Interbotix/ArbotixPro/README.md

# ArbotixPro
Eagle design files for Arbotix-Pro Robocontroller & source for CM730-compatible & ROS firmware versions.
