Interbotix/ArbotixPro/software/arbotixpro_cm730_firmware/README.md

# ArbotixPro-Firmware
Modified CM730 Firmware from ROBOTIS, compatible with HR-OS1/5 Framework

Compiled on Ubuntu 14.10, dependencies: https://launchpad.net/~terry.guo/+archive/ubuntu/gcc-arm-embedded
