Interbotix/ArbotixPro/hardware/CM730-ArbotixPro Pin Mappings.xlsx

STM32F10 Pin | Description | CM-730 | Arbotix-Pro | Notes | Legend
1 | Vbat | 3.3V | 3.3V |  | Pin Difference between CM-730 and Arbotix-Pro
2 | PC13-Tamper-RTC | LED_TX | LED_TX |  | CM-730 Pinout
3 | PC14 | LED_RX | LED_RX |  | Arbotix-Pro Pinout
4 | PC15 | LED2 | LED2
5 | OSC_IN | XTAL1 | XTAL1
6 | OSC_OUT | XTAL2 | XTAL2
7 | NRST | RESET | RESET
8 | PC0-ADC0 | SIG_ADC0 | SIG_ADC0
9 | PC1-ADC1 | SIG_ADC1 | SIG_ADC1
10 | PC2-ADC2 | SIG_ADC2 | SIG_ADC2
11 | PC3-ADC3 | SIG_ADC3 | SIG_ADC3
12 | VSSA | GND | GND
13 | VDDA | 3.3V | 3.3V
14 | PA0-ADC4 | SIG_ADC4 | SIG_ADC4
15 | PA1-ADC5 | SIG_ADC5 | SIG_ADC5
16 | PA2-ADC6 | SIG_ADC6 | SIG_ADC6
17 | PA3-ADC7 | SIG_ADC7 | SIG_ADC7
18 | VSS4 | GND | GND
19 | VDD4 | 3.3V | 3.3V
20 | PA4-ADC8 | SIG_ADC8 | SIG_ADC8
21 | PA5-ADC9 | SIG_ADC9 | SIG_ADC9
22 | PA6-ADC10 | SIG_ADC10 | SIG_ADC10
23 | PA7-ADC11 | SIG_ADC11 | SIG_ADC11
24 | PC4-ADC12 | SIG_ADC12 | SIG_ADC12
25 | PC5-ADC13 | SIG_ADC13 | SIG_ADC13
26 | PB0-ADC14 | SIG_ADC14 | SIG_ADC14
27 | PB1-ADC15 | SIG_ADC15 | SIG_ADC15
28 | PB2-BOOT1 | BOOT1/GND | BOOT1/GND
29 | PB10-TX3 | PC_TXD | PC_TXD
30 | PB11-RX3 | PC_RXD | PC_RXD
31 | VSS1 | GND | GND
32 | VDD1 | 3.3V | 3.3V
33 | PB12 | LED3 | LED3
34 | PB13-SCK2 | SIG_SCK | SIG_SCK
35 | PB14-MISO2 | SIG_MISO | SIG_MISO
36 | PB15-MOSI2 | SIG_MOSI | SIG_MOSI
37 | PC6-SDIO-D6 | LED4 | LED4
38 | PC7-SDIO-D7 | LED5_R | PIN_PC7
39 | PC8-SDIO-D0 | LED5_G | ENABLE_ZIGBEE
40 | PC9-SDIO-D1 | LED5_B | ENABLE_TX
41 | PA8 | LED6_R | PIN_PA8
42 | PA9-TX1 | CPU_TXD | CPU_TXD
43 | PA10-RX1 | CPU_RXD | CPU_RXD
44 | PA11-USBDM | LED6_G | SW_MODE
45 | PA12-USBDP | LED6_B | SW_START
46 | PA13-JTMS-SWDIO | USB_SLEEP | PIN_PA13 | JTMS
47 | VSS2 | GND | GND
48 | VDD2 | 3.3V | 3.3V
49 | PA14-JTCK-SWCLK | SW_MODE | PIN_PA14 | JTCK
50 | PA15-JTDI | SW_START | PIN_PA15 | JTDI
51 | PC10-TX4 | SIG_ACC_CS | SIG_ACC_CS
52 | PC11-RX4 | SIG_GYRO_CS | SIG_GYRO_CS
53 | PC12-TX5 | ZIGBEE_TXD | ZIGBEE_TXD
54 | PD2-RX5 | ZIGBEE_RXD | ZIGBEE_RXD
55 | PB3-JTDO | ENABLE_ZIGBEE | PIN_PB3 | JTDO
56 | PB4-MISO3 | ENABLE_TX | PIN_PB4 | NJRST
57 | PB5-MOSI3 | ENABLE_RX | ENABLE_RX
58 | PB6-TX1 | DXLTXD | DXLTXD
59 | PB7-RX1 | DXLRXD | DXLRXD
60 | BOOT0 | BOOT0/GND | BOOT0/GND
61 | PB8-D4 | ENABLE_DXLPWR | ENABLE_DXLPWR
62 | PB9-D5 | SIG_BUZZER | SIG_BUZZER
63 | VSS3 | GND | GND
64 | VDD3 | 3.3V | 3.3V
