Interbotix/ArbotixPro/hardware/arbotixpro.png

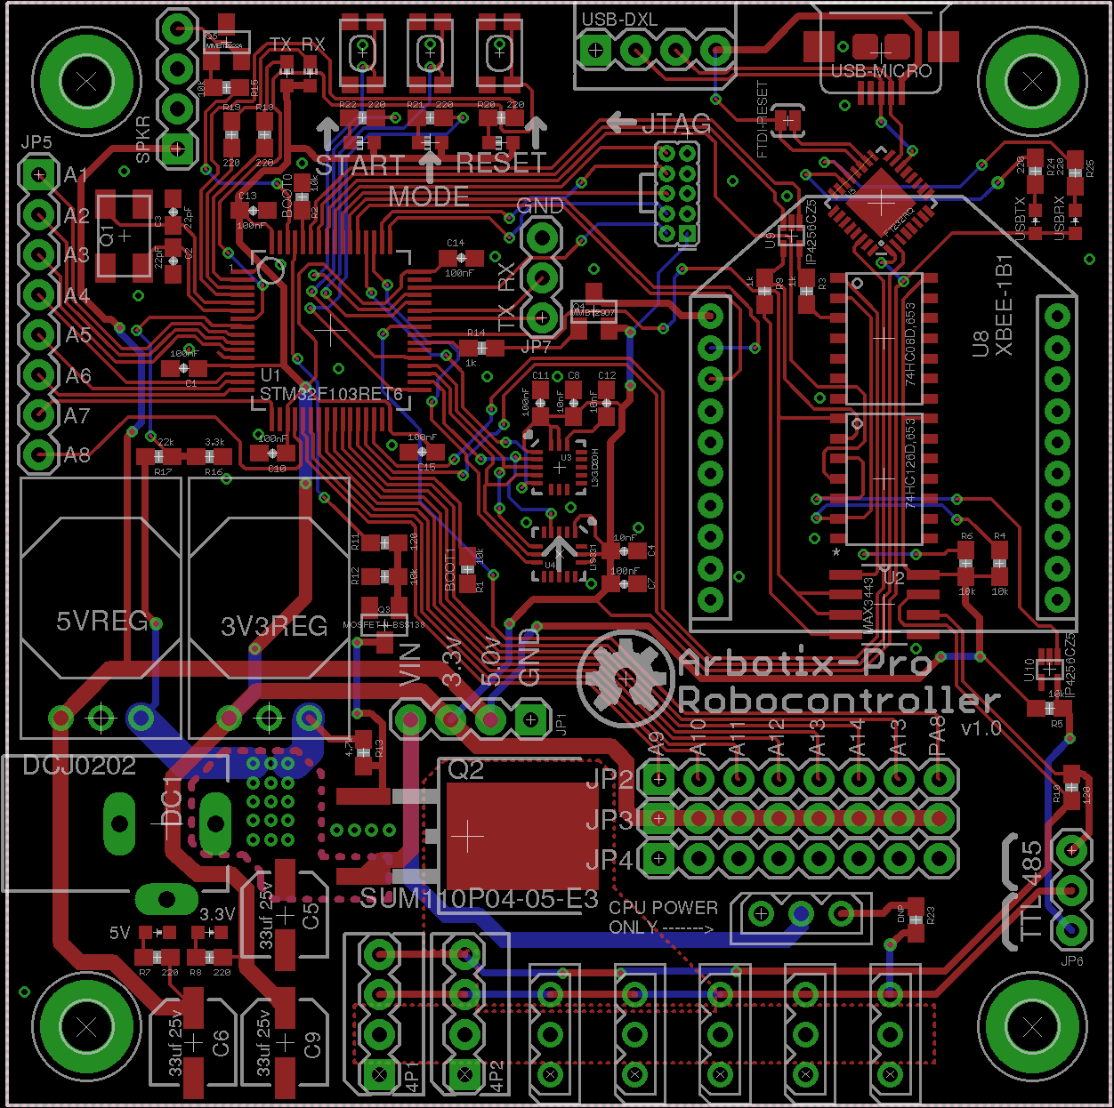
hardware/arbotixpro.png
