Interbotix/ArbotixPro/hardware/jtag.png

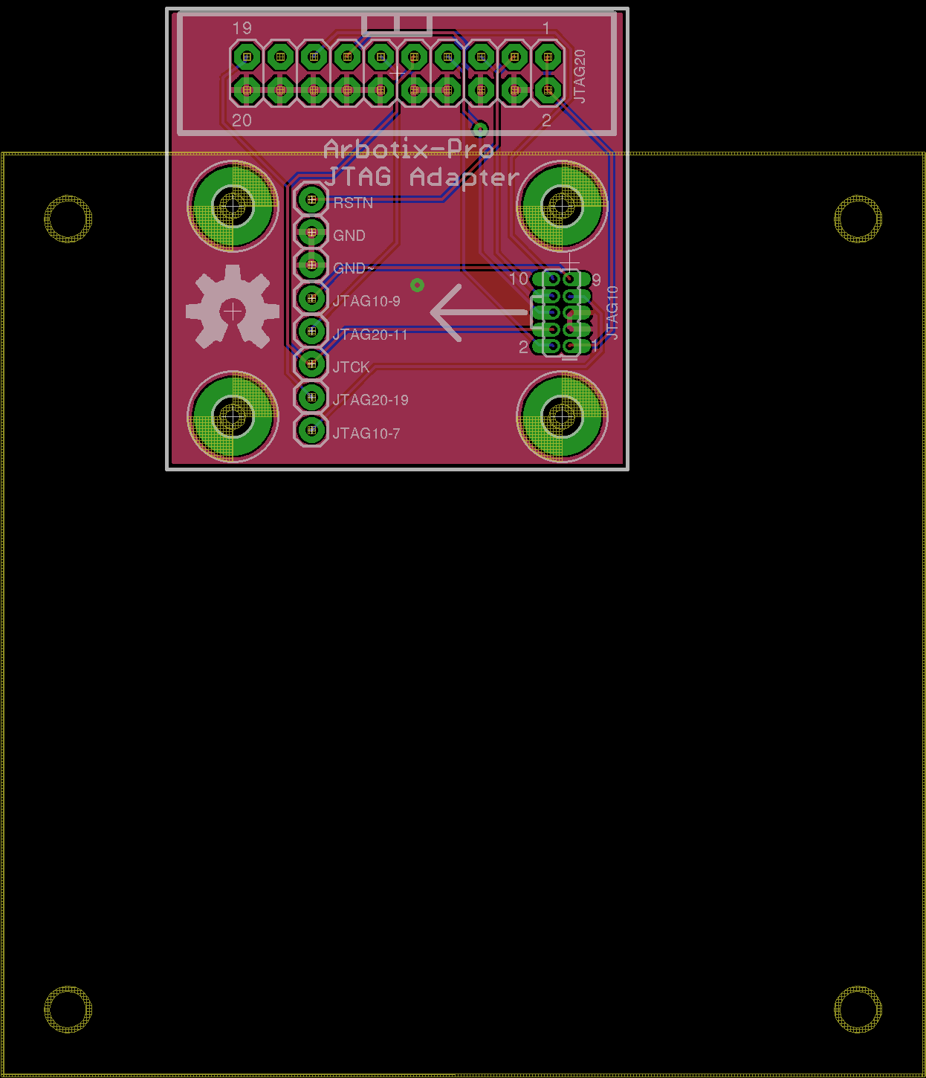
hardware/jtag.png
