Interbotix/ArbotixPro/hardware/Arbotix-Pro Digikey BOM v11.xlsx

Sheet: Part List Report
#ITEM | Description | Designator | Manufacturer | Manufacturer Part Number# | Supplier | EagleCAD Device | Supplier Part # | QTY/BOARD
1 | LED 1.6X0.8MM 568NM GRN CLR SMD | 3.3V, 5V, MODE, RESET, START, TX, RX, USBTX, USBRX | KINGBRIGHT COMPANY LLC (VA) | APT1608SGC | Digi-Key | LEDCHIPLED_0603 | 754-1121-6-ND | 9
2 | CONN HEADER 3POS 2.5MM VERT TIN | 3P1, 3P2, 3P3, 3P4, 3P5, CPU-POWER | MOLEX INC | 22035035 | Digi-Key | WM18887-ND | WM18887-ND | 6
3 | CONV DC/DC 1.5A 24VIN 3.3VOUT | 3V3REG | MURATA POWER SOLUTIONS INC | OKI-78SR-3.3/1.5-W36H-C | Digi-Key | DCDC_OKI-78SR | 811-3014-ND | 1
4 | CONN HEADER 4POS 2.5MM VERT TIN | 4P1, 4P2, USB-DXL | MOLEX INC | 22035045 | Digi-Key | M04PTH | WM18888-ND | 3
5 | DC/DC CONVERTER 5V 8W | 5VREG | MURATA POWER SOLUTIONS INC | OKI-78SR-5/1.5-W36H-C | Digi-Key | DCDC_OKI-78SR | 811-2692-ND | 1
6 | CAP CER 0.1UF 50V 10% X7R 0603 | C1, C7, C10, C11, C13, C14, C15 | TDK CORPORATION (VA) | C1608X7R1H104K080AA | Digi-Key | CAP0603-CAP | 445-1314-6-ND | 7
7 | CAP CER 22PF 50V 5% NP0 0603 | C2, C3 | MURATA ELECTRONICS (VA) | GRM1885C1H220JA01D | Digi-Key | 22PF-50V-5%(0603) | 490-1411-6-ND | 2
8 | CAP CER 10000PF 25V 5% C0G 0603 | C4, C8, C12 | TDK CORPORATION (VA) | C1608C0G1E103J080AA | Digi-Key | CAP0603-CAP | 445-2664-6-ND | 3
9 | CAP ALUM 33UF 25V 20% SMD | C5, C6, C9 | PANASONIC ELECTRONIC COMPONENTS (VA) | EEE-1EA330WR | Digi-Key | CBP-SV-C | PCE3904DKR-ND | 3
10 | CONN JACK POWER 2.1MM PCB | DC1 | CUI INC | PJ-102A | Digi-Key | DCJ0202 | CP-102A-ND | 1
11 | DNP | FTDI-RESET | DNP | DNP | Digi-Key | SOLDERJUMPERNO | DNP | 0
12 | CONN HEADER .100" SNGL STR 4POS | JP1, SPKR | SULLINS CONNECTOR SOLUTIONS (VA) | PRPC004SAAN-RC | Digi-Key | M04PTH | S1011EC-04-ND | 2
13 | CONN HEADER .100" SNGL STR 8POS | JP2, JP3, JP4, JP5 | SULLINS CONNECTOR SOLUTIONS (VA) | PRPC008SAAN-RC | Digi-Key | M081X08 | S1011EC-08-ND | 4
14 | CONN HEADER .100" SNGL STR 3POS | JP6, JP7 | SULLINS CONNECTOR SOLUTIONS (VA) | PRPC003SAAN-RC | Digi-Key | M03PTH | S1011EC-03-ND | 2
15 | CONN HEADER .050" 10PS DL PCB AU | JTAG | SULLINS CONNECTOR SOLUTIONS | GRPB052VWVN-RC | Digi-Key | GRPB052VWVN-RC | S9015E-05-ND | 1
16 | CRYSTAL 8MHZ 18PF SMD | Q1 | ABRACON CORPORATION (VA) | ABM3B-8.000MHZ-B2-T | Digi-Key | AMB3B-25.000MHZ-B2-T8MHZ8MHZ | 535-9720-6-ND | 1
17 | MOSFET P-CH 40V 110A D2PAK | Q2 | VISHAY SILICONIX (VA) | SUM110P04-05-E3 | Digi-Key | SPB80P06P | SUM110P04-05-E3DKR-ND | 1
18 | MOSFET N-CH 50V 220MA SOT-23 | Q3 | FAIRCHILD SEMICONDUCTOR (VA) | BSS138 | Digi-Key | MOSFET-NCHANNELBSS138 | BSS138CT-ND | 1
19 | TRANS PNP 60V 0.8A SOT-23 | Q4 | FAIRCHILD SEMICONDUCTOR (VA) | MMBT2907A | Digi-Key | TRANSISTOR_PNPMMBT4403 | MMBT2907AFSDKR-ND | 1
20 | TRANS NPN 40V 1A SOT-23 | Q5 | FAIRCHILD SEMICONDUCTOR (VA) | MMBT2222A | Digi-Key | TRANSISTOR_PNPMMBT4403 | MMBT2222AFSDKR-ND | 1
21 | RES SMD 10K OHM 1% 1/10W 0603 | R1, R2, R4, R5, R6, R12, R15 | PANASONIC ELECTRONIC COMPONENTS (VA) | ERJ-3EKF1002V | Digi-Key | RESISTOR0603-RES | P10.0KHDKR-ND | 7
22 | RES SMD 1K OHM 1% 1/10W 0603 | R3, R9, R14 | PANASONIC ELECTRONIC COMPONENTS (VA) | ERJ-3EKF1001V | Digi-Key | RESISTOR0603-RES | P1.00KHDKR-ND | 3
23 | RES SMD 220 OHM 1% 1/10W 0603 | R7, R8, R18, R19, R20, R21, R22, R24, R25 | PANASONIC ELECTRONIC COMPONENTS (VA) | ERJ-3EKF2200V | Digi-Key | RESISTOR0603 | P220HDKR-ND | 9
24 | RES SMD 120 OHM 1% 1/10W 0603 | R10, R11 | PANASONIC ELECTRONIC COMPONENTS (VA) | ERJ-3EKF1200V | Digi-Key | RESISTOR0603-RES | P120HDKR-ND | 2
25 | RES SMD 4.7K OHM 1% 1/10W 0603 | R13 | PANASONIC ELECTRONIC COMPONENTS (VA) | ERJ-3EKF4701V | Digi-Key | RESISTOR0603-RES | P4.70KHDKR-ND | 1
26 | RES SMD 3.3K OHM 1% 1/10W 0603 | R16 | PANASONIC ELECTRONIC COMPONENTS (VA) | ERJ-3EKF3301V | Digi-Key | RESISTOR0603-RES | P3.30KHDKR-ND | 1
27 | RES SMD 22K OHM 1% 1/10W 0603 | R17 | PANASONIC ELECTRONIC COMPONENTS (VA) | ERJ-3EKF2202V | Digi-Key | RESISTOR0603-RES | P22.0KHDKR-ND | 1
28 | DNP | R23 | DNP | DNP | Digi-Key | RESISTOR0603 | DNP | 0
29 | SWITCH TACTILE SPST-NO 0.05A 32V | SW1, SW2, SW3 | C&K COMPONENTS (VA) | KMR221NG LFS | Digi-Key | SPST_TACT-KMR2 | CKN10244DKR-ND | 3
30 | MCU ARM 512KB FLASH MEM 64-LQFP | U1 | STMICROELECTRONICS | STM32F103RET6 | Digi-Key | STM32F103RET6 | 497-6444-ND | 1
31 | IC TXRX RS-485 8-SOIC | U2 | MAXIM INTEGRATED | MAX3443EASA+ | Digi-Key | MAX3443EESA+ | MAX3443EASA+-ND | 1
32 | IC MEMS MOTION SENSOR 16LLGA | U3 | STMICROELECTRONICS (VA) | L3GD20HTR | Digi-Key | L3GD20H | 497-13931-6-ND | 1
33 | ACCELEROMETER MEMS 3AXIS 16-LGA | U4 | STMICROELECTRONICS (VA) | LIS331DLHTR | Digi-Key | LIS331 | 497-10397-6-ND | 1
34 | IC USB FS SERIAL UART 32-QFN | U5 | FTDI (VA) | FT232RQ-REEL | Digi-Key | FT232RQ | 768-1008-6-ND | 1
35 | IC GATE AND 4CH 2-INP 14-SO | U6 | NXP SEMICONDUCTORS (VA) | 74HC08D,653 | Digi-Key | 74HCT08D,653 | 568-1386-6-ND | 1
36 | IC BUFFER DVR TRI-ST QD 14SOIC | U7 | NXP SEMICONDUCTORS (VA) | 74HC126D,653 | Digi-Key | 74HC126D,653 | 568-8130-6-ND | 1
37 | CONN RECEPT 2MM VERT AU 10POS | U8 | HARWIN INC | M22-7131042 | Digi-Key | XBEE-1B1 | 952-1354-5-ND | 2
38 | IC EMI FILTER ESD 2CH SOT665 | U9, U10 | NXP SEMICONDUCTORS (VA) | IP4256CZ5-W,115 | Digi-Key | IP4256CZ5-W,115 | 568-5871-6-ND | 2
39 | CONN RCPT MICRO USB B SMD R/A | USB-MICRO | HIROSE ELECTRIC CO LTD (VA) | ZX62-B-5PA(11) | Digi-Key | MICRO-USB-5P-340015001 | H11634DKR-ND | 1

Sheet: Project Information
Project Full Path
Project Filename
Variant Name
Data-Source Filename
Data-Source Full Path
Title
Total Quantity
Report Time
Report Date
Report Date & Tine
Output Name
Output Type
Output Generator Name
Output Generator Description

Sheet: EagleImport
User | QTY | Part | Value | Device | Package | Description | MF | MPN | OC_FARNELL | OC_NEWARK | PACKAGE | PROD_ID | SUPPLIER | VALUE
1 | 7 | 3.3V, 5V, MODE, RESET, START, TX, RX |  | LEDCHIPLED_0603 | CHIPLED_0603 | LED
2 | 6 | 3P1, 3P2, 3P3, 3P4, 3P5, CPU-POWER | WM18887-ND | WM18887-ND | BIOLOID | Bioloid Bus Header
3 | 1 | 3V3REG | DCDC_OKI-78SR-3.3 | DCDC_OKI-78SR | OKI-78SRH | 4.95W DC/DC Converter
4 | 3 | 4P1, 4P2, USB-DXL |  | M04PTH | 1X04 | Header 4
5 | 1 | 5VREG | DCDC_OKI-78SR-5 | DCDC_OKI-78SR | OKI-78SRH | 4.95W DC/DC Converter
6 | 7 | C1, C7, C10, C11, C13, C14, C15 | 100nF | CAP0603-CAP | 0603-CAP | Capacitor
7 | 2 | C2, C2 | 22pF | 22PF-50V-5%(0603) | 0603-CAP | CAP-07876 |  |  |  |  |  | CAP-07876 |  | 22pF
8 | 3 | C4, C8, C12 | 10nF | CAP0603-CAP | 0603-CAP | Capacitor
9 | 3 | C5, C6, C9 | 33uf 25v | CBP-SV-C | SV-C | BIPOLAR CAP
10 | 1 | DC1 | DCJ0202 | DCJ0202 | DCJ0202 | DC POWER JACK |  |  | unknown | unknown
11 | 0 | FTDI-RESET | DNP | SOLDERJUMPERNO | SJ_2S-NO | Solder Jumper
12 | 2 | JP1, SPKR |  | M04PTH | 1X04 | Header 4
13 | 4 | JP2, JP3, JP4, JP5 |  | M081X08 | 1X08 | Header 8
14 | 2 | JP6, JP7 |  | M03PTH | 1X03 | Header 3
15 | 1 | JTAG | GRPB052VWQS-RC | GRPB052VWQS-RC | DEBUG | CONN HEADER 0.050 10PS DL SMD AU"
16 | 1 | Q1 | 8MHZ | AMB3B-25.000MHZ-B2-T8MHZ8MHZ | 4LCC | CRYSTAL, 8.000MHZ 18PF SMD
17 | 1 | Q2 | SUM110P04-05-E3 | SPB80P06P | TO263 | SIPMOS (R) Power-Transistor P-Channel, Enhancement mode
18 | 1 | Q3 | MOSFET-N-BSS138 | MOSFET-NCHANNELBSS138 | SOT23 | Common NMOSFET Parts |  |  |  |  |  | TRANS-00830
19 | 1 | Q4 | MMBT2907 | TRANSISTOR_PNPMMBT4403 | SOT23 | Generic PNP BJT |  |  |  |  |  | TRANS-09245 |  | MMBT4403
20 | 1 | Q5 | MMBT2222A | TRANSISTOR_PNPMMBT4403 | SOT23 | Generic PNP BJT |  |  |  |  |  | TRANS-09245 |  | MMBT4403
21 | 7 | R1, R2, R4, R5, R6, R12, R15 | 10k | RESISTOR0603-RES | 0603-RES | Resistor
22 | 3 | R3, R9, R14 | 1k | RESISTOR0603-RES | 0603-RES | Resistor
23 | 7 | R7, R8, R18, R19, R20, R21, R22 | 220 | RESISTOR0603 | 0603-RES | Resistor
24 | 2 | R10, R11 | 120 | RESISTOR0603-RES | 0603-RES | Resistor
25 | 1 | R13 | 4.7k | RESISTOR0603-RES | 0603-RES | Resistor
26 | 1 | R16 | 3.3k | RESISTOR0603-RES | 0603-RES | Resistor
27 | 1 | R17 | 22k | RESISTOR0603-RES | 0603-RES | Resistor
28 | 0 | R23 | DNP | RESISTOR0603 | 0603-RES | Resistor
29 | 3 | SW1, SW2, SW3 | SPST_TACT-KMR2 | SPST_TACT-KMR2 | KMR2 | SMT 6mm switch, EVQQ2 series
30 | 1 | U1 | STM32F103RET6 | STM32F103RET6 | QFP50P1200X1200X160-64N | ARM-based 32-bit MCU |  | STM32F103RET6 | 1624138 | 01P4101 | QFP-64 |  | STMICROELECTRONICS
31 | 1 | U2 | MAX3443 | MAX3443EESA+ | SOIC127P600X175-8N | Transceivers |  | MAX3443EESA+ | 1593360 | 59J3022 | SOIC-8 |  | Maxim
32 | 1 | U3 | L3GD20H | L3GD20H | LGA16-3MM
33 | 1 | U4 | LIS331 | LIS331 | LGA16-3MM | 3-axis 6/12/24g SPI/I2C accelerometer
34 | 1 | U5 | FT232RQ | FT232RQ | QFN-32 | USB to USART. Non-stock item, unproven FP for this part.
35 | 1 | U6 | 74HC08D,653 | 74HCT08D,653 | 14-SOIC
36 | 1 | U7 | 74HC126D,653 | 74HC126D,653 | 14-SOIC
37 | 1 | U8 | XBEE-1B3 | XBEE-1B3 | XBEE-SMD | Xbee module footprints |  |  |  |  |  | CONN-09042
38 | 2 | U9, U10 | IP4256CZ5-W,115 | IP4256CZ5-W,115 | SOT665
39 | 1 | USB-MICRO | MICRO-USB-5P-340015001 | MICRO-USB-5P-340015001 | B-SMD-5P | ST-USB-001Eï¼šMICRO USB B SMD R/A

Sheet: digimport
Digi-Key Part Number | Manufacturer | Manufacturer Part Number | Description | Customer Reference | Quantity 1 | Price | Quantity 2 | Price | Quantity 3 | Price | Stock Status | Mfg Std Lead Time | Comments | RoHS Status | Lead Free Status | REACH Status
754-1121-6-ND | KINGBRIGHT COMPANY LLC (VA) | APT1608SGC | LED 1.6X0.8MM 568NM GRN CLR SMD | 1 | 9 | 0.93778 | 504 | 0.08409 | 1008 | 0.07714 | IN STOCK | 6-8 Weeks | Non-Cancelable/Non-Returnable | RoHS Compliant | Lead free | Unaffected Jun-2014
WM18887-ND | MOLEX INC | 22035035 | CONN HEADER 3POS 2.5MM VERT TIN | 2 | 6 | 0.53 | 336 | 0.34796 | 672 | 0.3314 | IN STOCK | 8 Weeks |  | RoHS Compliant | Lead free | Unaffected Dec-2009
811-3014-ND | MURATA POWER SOLUTIONS INC | OKI-78SR-3.3/1.5-W36H-C | CONV DC/DC 1.5A 24VIN 3.3VOUT | 3 | 1 | 4.74 | 56 | 4.336 | 112 | 4.2005 | IN STOCK | 10 Weeks |  | RoHS Compliant | Lead free | Not Available
WM18888-ND | MOLEX INC | 22035045 | CONN HEADER 4POS 2.5MM VERT TIN | 4 | 3 | 0.62 | 168 | 0.4487 | 336 | 0.40972 | IN STOCK | 8 Weeks |  | RoHS Compliant | Lead free | Unaffected Dec-2009
811-2692-ND | MURATA POWER SOLUTIONS INC | OKI-78SR-5/1.5-W36H-C | DC/DC CONVERTER 5V 8W | 5 | 1 | 4.3 | 56 | 4.04 | 112 | 3.78 | IN STOCK | 10 Weeks |  | RoHS Compliant | Lead free | Not Available
445-1314-6-ND | TDK CORPORATION (VA) | C1608X7R1H104K080AA | CAP CER 0.1UF 50V 10% X7R 0603 | 6 | 7 | 1.1 | 392 | 0.03587 | 784 | 0.02432 | IN STOCK | 10 Weeks | Non-Cancelable/Non-Returnable | RoHS Compliant | Lead free | Unaffected Apr-2011
490-1411-6-ND | MURATA ELECTRONICS (VA) | GRM1885C1H220JA01D | CAP CER 22PF 50V 5% NP0 0603 | 7 | 2 | 3.6 | 112 | 0.08134 | 224 | 0.05004 | IN STOCK | 18 Weeks | Non-Cancelable/Non-Returnable | RoHS Compliant | Lead free | Unaffected Jul-2011
445-2664-6-ND | TDK CORPORATION (VA) | C1608C0G1E103J080AA | CAP CER 10000PF 25V 5% C0G 0603 | 8 | 3 | 2.67333 | 168 | 0.18167 | 336 | 0.12583 | IN STOCK | 12 Weeks | Non-Cancelable/Non-Returnable | RoHS Compliant | Lead free | Unaffected Apr-2011
PCE3904DKR-ND | PANASONIC ELECTRONIC COMPONENTS (VA) | EEE-1EA330WR | CAP ALUM 33UF 25V 20% SMD | 9 | 3 | 2.77333 | 168 | 0.24929 | 336 | 0.17652 | IN STOCK | 21 Weeks | Non-Cancelable/Non-Returnable | RoHS Compliant | Lead free | Not Available
CP-102A-ND | CUI INC | PJ-102A | CONN JACK POWER 2.1MM PCB | 10 | 1 | 1 | 56 | 0.7 | 112 | 0.47 | IN STOCK | 11 Weeks |  | RoHS Compliant | Lead free | Unaffected Oct-2010
 |  |  |  | 11
S1011EC-04-ND | SULLINS CONNECTOR SOLUTIONS (VA) | PRPC004SAAN-RC | CONN HEADER .100" SNGL STR 4POS | 12 | 2 | 0.2 | 112 | 0.1443 | 224 | 0.1443 |  |  | No delivery date available | RoHS Compliant | Lead free | Unaffected Dec-2013
S1011EC-08-ND | SULLINS CONNECTOR SOLUTIONS (VA) | PRPC008SAAN-RC | CONN HEADER .100" SNGL STR 8POS | 13 | 4 | 0.26 | 224 | 0.1935 | 448 | 0.1935 |  |  | No delivery date available | RoHS Compliant | Lead free | Unaffected Dec-2013
S1011EC-03-ND | SULLINS CONNECTOR SOLUTIONS (VA) | PRPC003SAAN-RC | CONN HEADER .100" SNGL STR 3POS | 14 | 2 | 0.18 | 112 | 0.132 | 224 | 0.132 |  |  | No delivery date available | RoHS Compliant | Lead free | Unaffected Dec-2013
S9015E-05-ND | SULLINS CONNECTOR SOLUTIONS | GRPB052VWVN-RC | CONN HEADER .050" 10PS DL PCB AU | 15 | 1 | 0.9 | 56 | 0.6232 | 112 | 0.554 | IN STOCK | 2-4 Weeks |  | RoHS Compliant | Lead free | Unaffected Dec-2013
535-9720-6-ND | ABRACON CORPORATION (VA) | ABM3B-8.000MHZ-B2-T | CRYSTAL 8MHZ 18PF SMD | 16 | 1 | 8.04 | 56 | 0.98375 | 112 | 0.8225 | IN STOCK | 10 Weeks | Non-Cancelable/Non-Returnable | RoHS Compliant | Lead free | Unaffected Jun-2014
SUM110P04-05-E3DKR-ND | VISHAY SILICONIX (VA) | SUM110P04-05-E3 | MOSFET P-CH 40V 110A D2PAK | 17 | 1 | 11.92 | 56 | 4.09214 | 112 | 3.67063 | IN STOCK | 16 Weeks | Non-Cancelable/Non-Returnable | RoHS Compliant | Lead free | Unaffected Dec-2011
BSS138CT-ND | FAIRCHILD SEMICONDUCTOR (VA) | BSS138 | MOSFET N-CH 50V 220MA SOT-23 | 18 | 1 | 0.22 | 56 | 0.1408 | 112 | 0.1096 | IN STOCK | 6 Weeks | Alternate Packaging Exists | RoHS Compliant | Lead free | Unaffected Dec-2013
MMBT2907AFSDKR-ND | FAIRCHILD SEMICONDUCTOR (VA) | MMBT2907A | TRANS PNP 60V 0.8A SOT-23 | 19 | 1 | 7.2 | 56 | 0.295 | 112 | 0.18491 | IN STOCK | 6 Weeks | Non-Cancelable/Non-Returnable | RoHS Compliant | Lead free | Unaffected Dec-2013
MMBT2222AFSDKR-ND | FAIRCHILD SEMICONDUCTOR (VA) | MMBT2222A | TRANS NPN 40V 1A SOT-23 | 20 | 1 | 7.18 | 56 | 0.27821 | 112 | 0.17277 | IN STOCK | 6 Weeks | Non-Cancelable/Non-Returnable | RoHS Compliant | Lead free | Unaffected Dec-2013
P10.0KHDKR-ND | PANASONIC ELECTRONIC COMPONENTS (VA) | ERJ-3EKF1002V | RES SMD 10K OHM 1% 1/10W 0603 | 21 | 7 | 1.1 | 392 | 0.0263 | 784 | 0.01517 | IN STOCK | 7 Weeks | Non-Cancelable/Non-Returnable | RoHS Compliant | Lead free | Not Available
P1.00KHDKR-ND | PANASONIC ELECTRONIC COMPONENTS (VA) | ERJ-3EKF1001V | RES SMD 1K OHM 1% 1/10W 0603 | 22 | 3 | 2.43333 | 168 | 0.0531 | 336 | 0.02929 | IN STOCK | 7 Weeks | Non-Cancelable/Non-Returnable | RoHS Compliant | Lead free | Not Available
P220HDKR-ND | PANASONIC ELECTRONIC COMPONENTS (VA) | ERJ-3EKF2200V | RES SMD 220 OHM 1% 1/10W 0603 | 23 | 9 | 0.87778 | 504 | 0.02012 | 1008 | 0.0111 | IN STOCK | 7 Weeks | Non-Cancelable/Non-Returnable | RoHS Compliant | Lead free | Not Available
P120HDKR-ND | PANASONIC ELECTRONIC COMPONENTS (VA) | ERJ-3EKF1200V | RES SMD 120 OHM 1% 1/10W 0603 | 24 | 2 | 3.6 | 112 | 0.07393 | 224 | 0.04263 | IN STOCK | 7 Weeks | Non-Cancelable/Non-Returnable | RoHS Compliant | Lead free | Not Available
P4.70KHDKR-ND | PANASONIC ELECTRONIC COMPONENTS (VA) | ERJ-3EKF4701V | RES SMD 4.7K OHM 1% 1/10W 0603 | 25 | 1 | 7.1 | 56 | 0.14 | 112 | 0.07393 | IN STOCK | 7 Weeks | Non-Cancelable/Non-Returnable | RoHS Compliant | Lead free | Not Available
P3.30KHDKR-ND | PANASONIC ELECTRONIC COMPONENTS (VA) | ERJ-3EKF3301V | RES SMD 3.3K OHM 1% 1/10W 0603 | 26 | 1 | 7.1 | 56 | 0.14 | 112 | 0.07393 | IN STOCK | 7 Weeks | Non-Cancelable/Non-Returnable | RoHS Compliant | Lead free | Not Available
P22.0KHDKR-ND | PANASONIC ELECTRONIC COMPONENTS (VA) | ERJ-3EKF2202V | RES SMD 22K OHM 1% 1/10W 0603 | 27 | 1 | 7.1 | 56 | 0.14 | 112 | 0.07393 | IN STOCK | 7 Weeks | Non-Cancelable/Non-Returnable | RoHS Compliant | Lead free | Not Available
 |  |  |  | 28
CKN10244DKR-ND | C&K COMPONENTS (VA) | KMR221NG LFS | SWITCH TACTILE SPST-NO 0.05A 32V | 29 | 3 | 2.84333 | 168 | 0.44339 | 336 | 0.38604 | IN STOCK | 8 Weeks | Non-Cancelable/Non-Returnable | RoHS Compliant | Lead free | Unaffected Jun-2013
497-6444-ND | STMICROELECTRONICS | STM32F103RET6 | MCU ARM 512KB FLASH MEM 64-LQFP | 30 | 1 | 10.05 | 56 | 9.045 | 112 | 7.437 | IN STOCK | 15 Weeks | Alternate Packaging Exists | RoHS Compliant | Lead free | Unaffected Jul-2011
MAX3443EASA+-ND | MAXIM INTEGRATED | MAX3443EASA+ | IC TXRX RS-485 8-SOIC | 31 | 1 | 4.91 | 56 | 4.2076 | 112 | 4.2076 | IN STOCK | 13 Weeks | Alternate Packaging Exists | RoHS Compliant | Lead free | Unaffected Jun-2012
497-13931-6-ND | STMICROELECTRONICS (VA) | L3GD20HTR | IC MEMS MOTION SENSOR 16LLGA | 32 | 1 | 12.14 | 56 | 4.26625 | 112 | 3.82893 | IN STOCK | 13 Weeks | Non-Cancelable/Non-Returnable | RoHS Compliant | Lead free | Not Available
497-10397-6-ND | STMICROELECTRONICS (VA) | LIS331DLHTR | ACCELEROMETER MEMS 3AXIS 16-LGA | 33 | 1 | 9.6 | 56 | 2.23143 | 112 | 1.95679 | IN STOCK | 13 Weeks | Non-Cancelable/Non-Returnable | RoHS Compliant | Lead free | Unaffected Jul-2011
768-1008-6-ND | FTDI (VA) | FT232RQ-REEL | IC USB FS SERIAL UART 32-QFN | 34 | 1 | 11.5 | 56 | 3.975 | 112 | 3.7125 | IN STOCK | 10 Weeks | Non-Cancelable/Non-Returnable | RoHS Compliant | Lead free | Unaffected Jun-2011
568-1386-6-ND | NXP SEMICONDUCTORS (VA) | 74HC08D,653 | IC GATE AND 4CH 2-INP 14-SO | 35 | 1 | 7.49 | 56 | 0.40857 | 112 | 0.28902 | IN STOCK | 16 Weeks | Non-Cancelable/Non-Returnable | RoHS Compliant | Lead free | Unaffected Jul-2011
568-8130-6-ND | NXP SEMICONDUCTORS (VA) | 74HC126D,653 | IC BUFFER DVR TRI-ST QD 14SOIC | 36 | 1 | 7.42 | 56 | 0.40429 | 112 | 0.28991 | IN STOCK | 16 Weeks | Non-Cancelable/Non-Returnable | RoHS Compliant | Lead free | Unaffected Jul-2011
952-1354-5-ND | HARWIN INC | M22-7131042 | CONN RECEPT 2MM VERT AU 10POS | 37 | 2 | 1.49 | 112 | 1.21 | 224 | 1.155 | IN STOCK | 6 Weeks |  | RoHS Compliant | Lead free | Unaffected Jun-2014
568-5871-6-ND | NXP SEMICONDUCTORS (VA) | IP4256CZ5-W,115 | IC EMI FILTER ESD 2CH SOT665 | 38 | 2 | 4.04 | 112 | 0.29286 | 224 | 0.26165 | IN STOCK | 8 Weeks | Non-Cancelable/Non-Returnable | RoHS Compliant | Lead free | Unaffected Jul-2011
H11634DKR-ND | HIROSE ELECTRIC CO LTD (VA) | ZX62-B-5PA(11) | CONN RCPT MICRO USB B SMD R/A | 39 | 1 | 7.96 | 56 | 0.88393 | 112 | 0.78848 | IN STOCK | 6-8 Weeks | Non-Cancelable/Non-Returnable | RoHS Compliant | Lead free | Unaffected Sep-2011
