Interbotix/ArbotixPro/hardware/ArbotixPro-JTAGProg.dxf

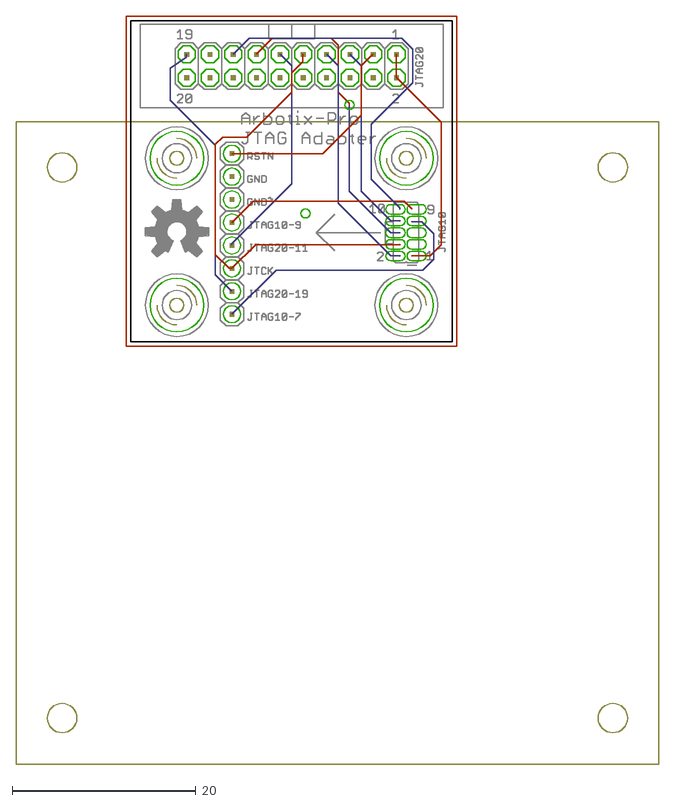
[picture p3: CAD file, 2015-04-29]
hardware/ArbotixPro-JTAGProg.dxf
70.0 x 81.5
