Interbotix/ArbotixPro/hardware/ArbotixPro.dxf

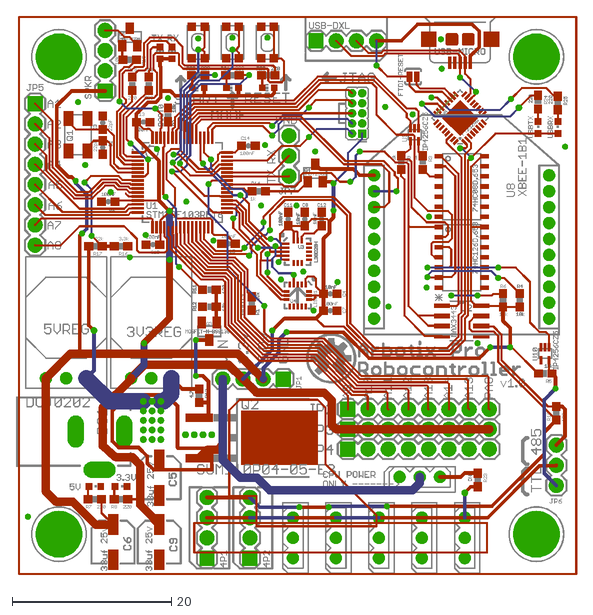
[picture p4: CAD file, 2015-04-29]
hardware/ArbotixPro.dxf
70.5 x 70.2
