Interbotix/ArbotixPro/(threads)

Thread 1 (2016-08-14):

error while compiling

ekorudiawan, 2016-08-14:
i get an error when compiling firmware both on windows and ubuntu,,

c:/program files (x86)/gnu tools arm embedded/5.4 2016q2/bin/../lib/gcc/arm-none-eabi/5.4.1/../../../../arm-none-eabi/bin/ld.exe: section .init loaded at [08004a38,08004a43] overlaps section .data loaded at [08004a38,08004d2b]
collect2.exe: error: ld returned 1 exit status
make: *** [CM730.elf] Error 1

i thing problem with linker script,, can u solve it
