Interbotix/ArbotixPro/hardware/ArbotixProSchematic.pdf

A

A

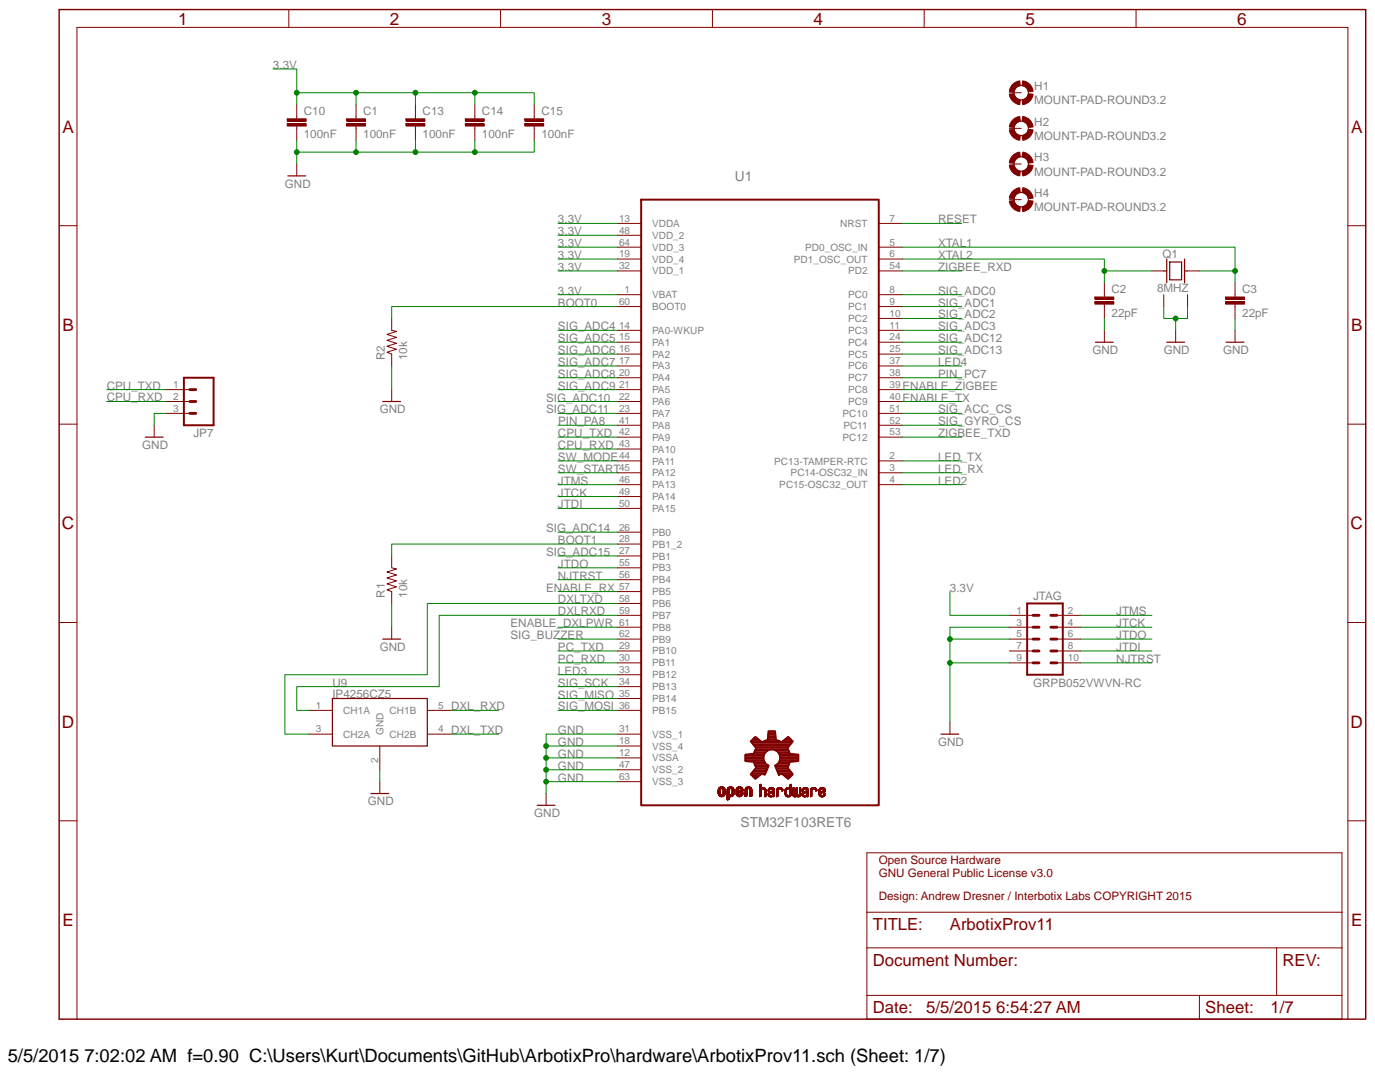
[picture p5: page 1]

Open Source Hardware
GNU General Public License v3.0
Design: Andrew Dresner / Interbotix Labs COPYRIGHT 2015
TITLE:

5/5/2015 7:02:02 AM f=0.90 C:\Users\Kurt\Documents\GitHub\ArbotixPro\hardware\ArbotixProv11.sch (Sheet: 1/7)

A

A

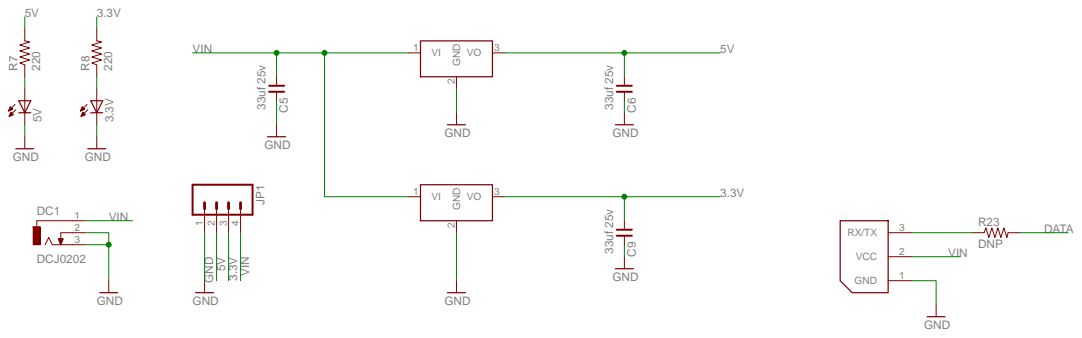
[picture p6: page 2]
GND; DCJ0202; DNP; VCC; VIN; DATA; REV:; TITLE:; Document Number:; ArbotixProv11

5/5/2015 7:02:02 AM f=0.90 C:\Users\Kurt\Documents\GitHub\ArbotixPro\hardware\ArbotixProv11.sch (Sheet: 2/7)

A

A

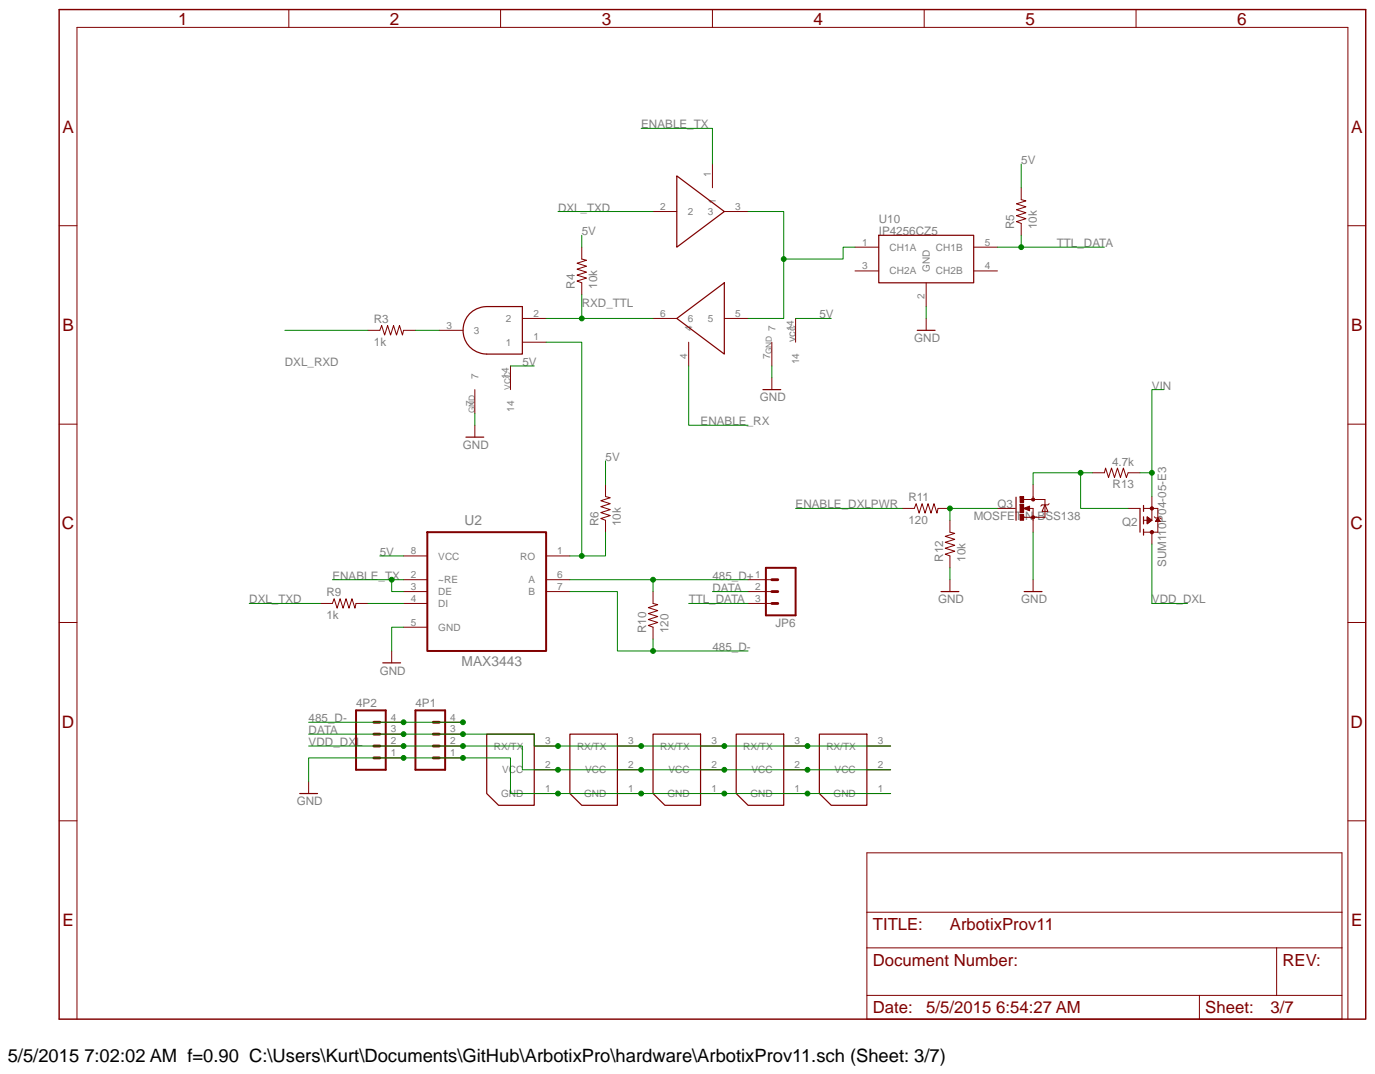
[picture p7: page 3]

5/5/2015 7:02:02 AM f=0.90 C:\Users\Kurt\Documents\GitHub\ArbotixPro\hardware\ArbotixProv11.sch (Sheet: 3/7)

A

A

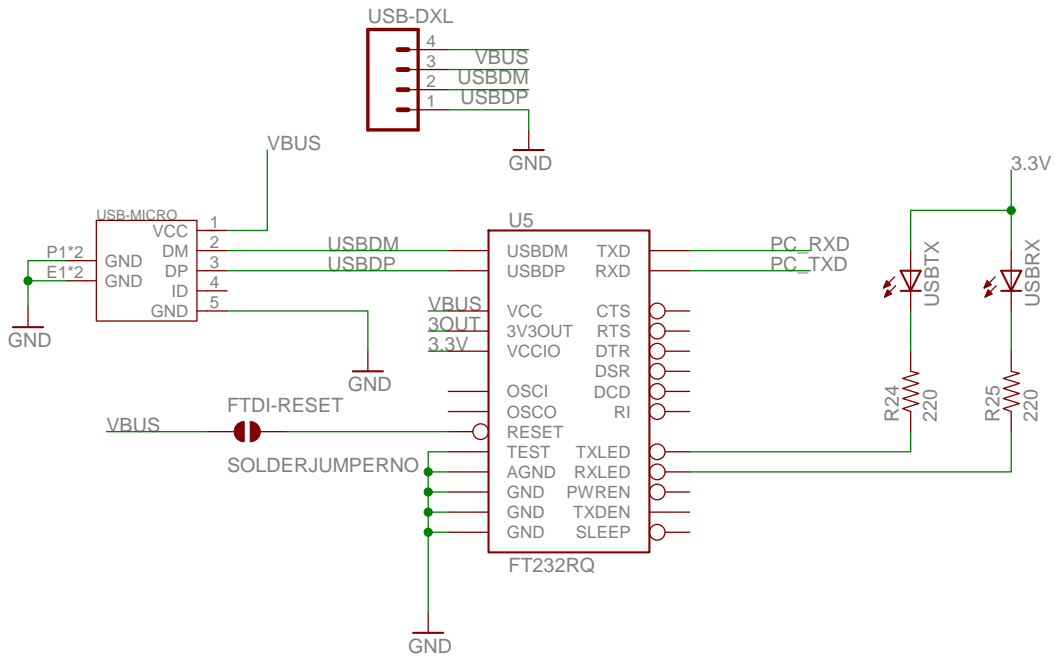
[picture p8: page 4]
GND; SOLDERJUMPERNO; VCC 1; GND E1*2; GND P1*2; USB-MICRO; RESET; OSCI OSCO; DSR DCD RI; 3V3OUT; USBDM USBDP; GND GND GND; TXD RXD; VCCIO; AGND; TEST; VCC; TXLED RXLED; RTS; CTS; DTR; PWREN TXDEN SLEEP; FTDI-RESET; USB-DXL; USBTX; USBRX; USBDM; USBDP; 3OUT; VBUS; PC_RXD PC_TXD; REV:; TITLE:; Document Number:; ArbotixProv11

5/5/2015 7:02:02 AM f=0.90 C:\Users\Kurt\Documents\GitHub\ArbotixPro\hardware\ArbotixProv11.sch (Sheet: 4/7)

A

A

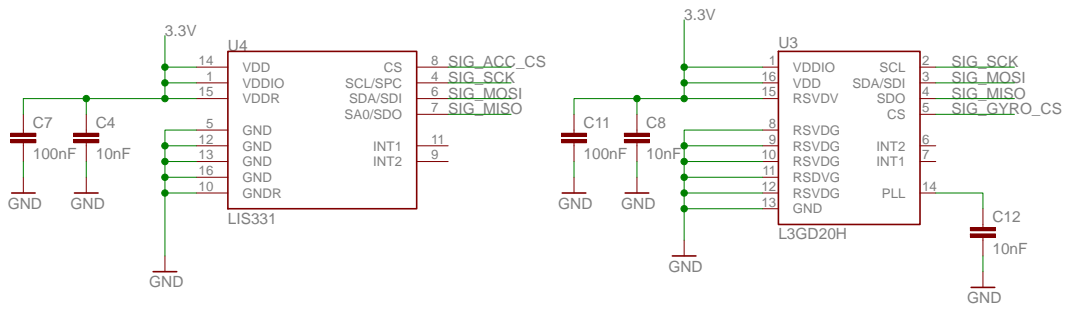
[picture p9: page 5]
LIS331; GND; U4 VDD 14; SCL/SPC; GND 5; GND 13; GND 12; INT1; GNDR 10; INT2; VDDIO 1 VDDR 15; GND 16; SA0/SDO; 7 SDA/SDI; VDDIO 1; SCL 2; SDA/SDI 3 SDO 4 CS 5; INT2 6 INT1 7; VDD 16 RSVDV 15; PLL 14; SIG_SCK; SIG_MISO; SIG_MOSI; SIG_ACC_CS; SIG_GYRO_CS; REV:; TITLE:; Document Number:; ArbotixProv11

RSVDG 8
GND 13 RSVDG 12 RSDVG 11 RSVDG 10 RSVDG 9

5/5/2015 7:02:02 AM f=0.90 C:\Users\Kurt\Documents\GitHub\ArbotixPro\hardware\ArbotixProv11.sch (Sheet: 5/7)

A

A

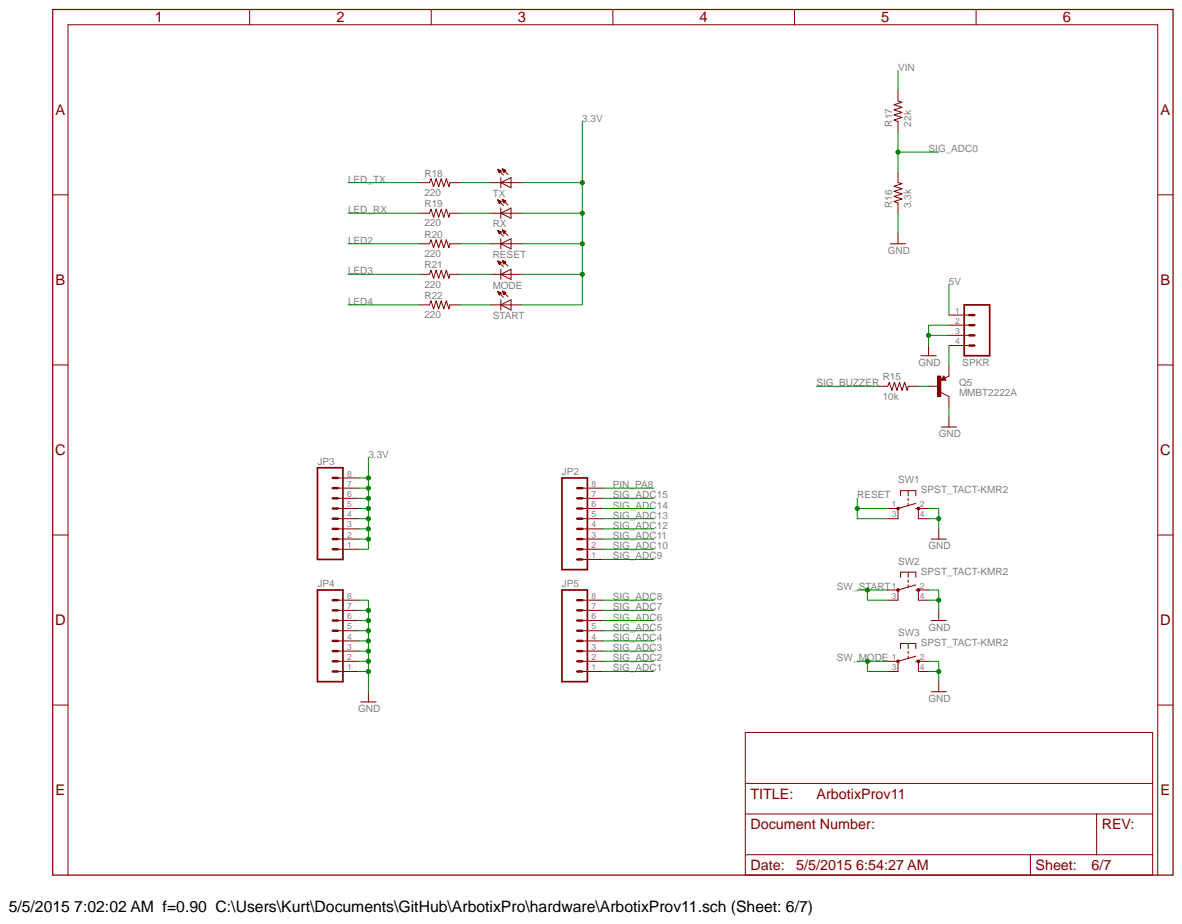
[picture p10: page 6]

5/5/2015 7:02:02 AM f=0.90 C:\Users\Kurt\Documents\GitHub\ArbotixPro\hardware\ArbotixProv11.sch (Sheet: 6/7)

A

A

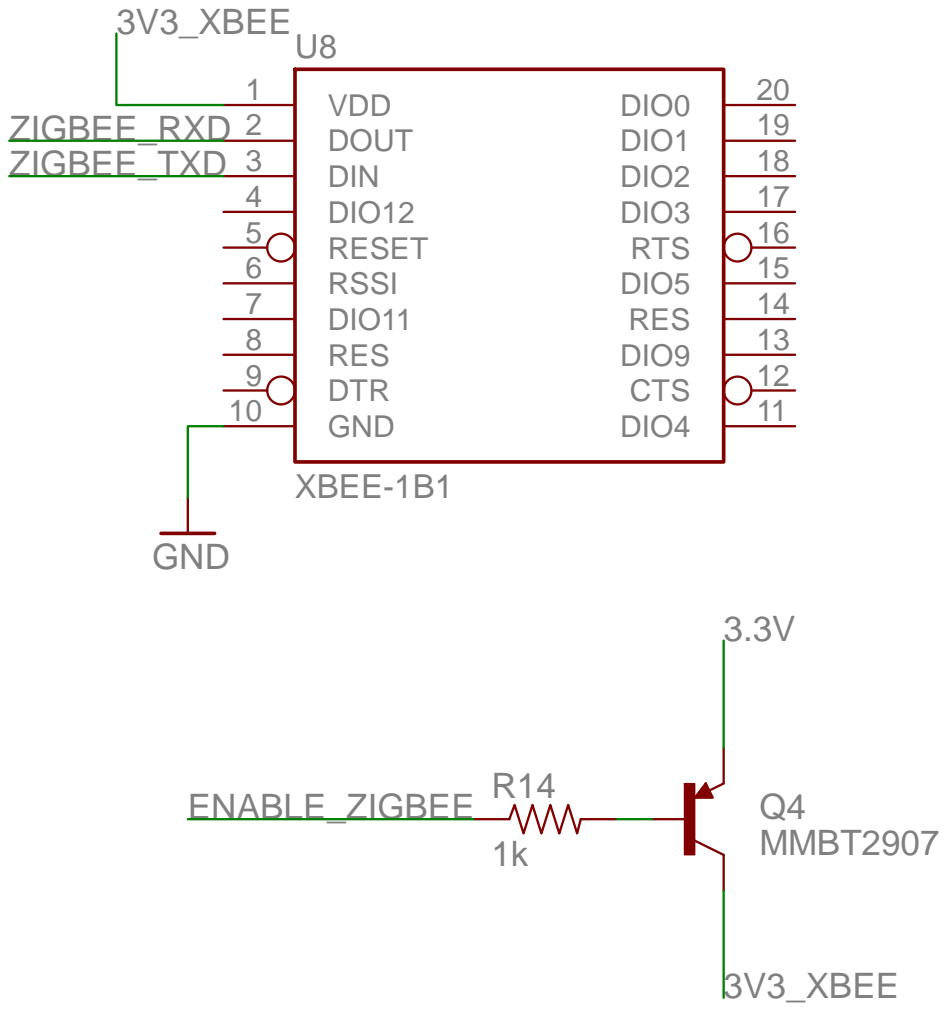
[picture p11: page 7]
MMBT2907 1k; XBEE-1B1; GND; CTS; DIN 3; DIO0; DIO1; DIO2; DIO3; DIO4; DIO5; DIO9; 13 DIO11 7; DIO12 4; DOUT 2; DTR 9 GND 10; RES 8; RES; RESET 5; RSSI 6; RTS; VDD 1; ENABLE_ZIGBEE; ZIGBEE_RXD ZIGBEE_TXD; 3V3_XBEE; REV:; TITLE:; Document Number:; ArbotixProv11

5/5/2015 7:02:02 AM f=0.90 C:\Users\Kurt\Documents\GitHub\ArbotixPro\hardware\ArbotixProv11.sch (Sheet: 7/7)
