Interbotix/ArbotixPro/hardware/ArbotixPro-JTAGProg.brd

## EAGLE design hardware/ArbotixPro-JTAGProg.brd (2015-04-29)

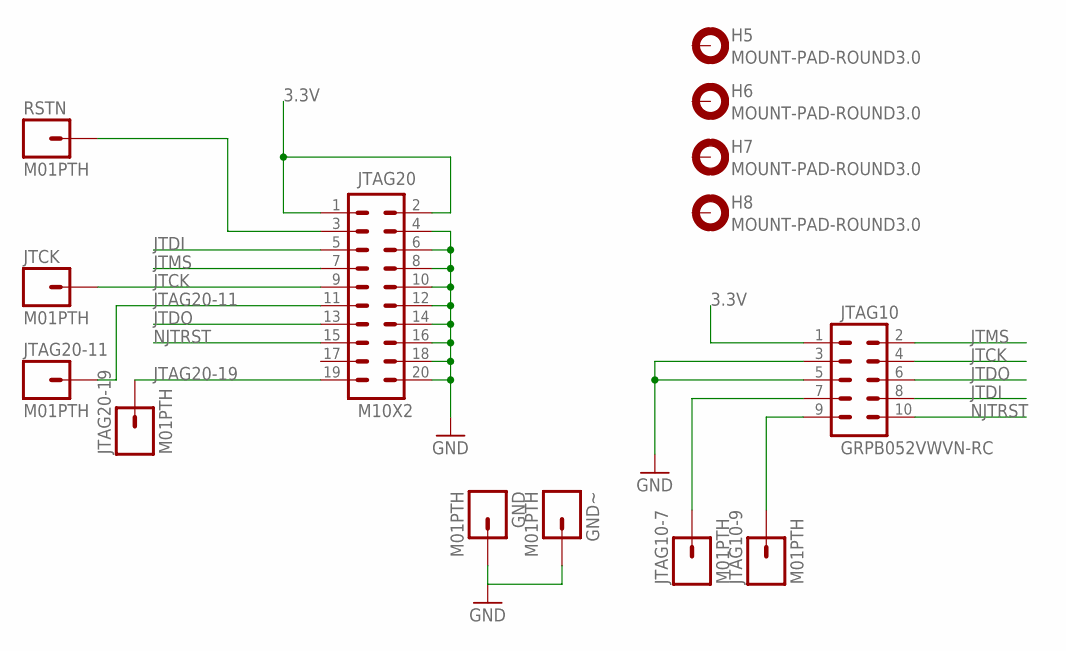
[picture p12: schematic ArbotixPro-JTAGProg.sch, MAIN]

Parts:
GND: M01PTH; 1X01
GND~: M01PTH; 1X01
H5, H6, H7, H8: MOUNT-PAD-ROUND3.0; 3,0-PAD
JTAG10: GRPB052VWVN-RC; 2X5_PTH_SILK_.05
JTAG10-7, JTAG10-9, JTAG20-11, JTAG20-19: M01PTH; 1X01
JTAG20: M10X2; 2X10
JTCK: M01PTH; 1X01
RSTN: M01PTH; 1X01

Connections:
3.3V: JTAG10.1, JTAG20.1, JTAG20.2
GND: GND.1, GND~.1, JTAG10.3, JTAG10.5, JTAG20.4, JTAG20.6, JTAG20.8, JTAG20.10, JTAG20.12, JTAG20.14, JTAG20.16, JTAG20.18, JTAG20.20
JTAG20-11: JTAG20.11, JTAG20-11.1
JTAG20-19: JTAG20.19, JTAG20-19.1
JTCK: JTAG10.4, JTAG20.9, JTCK.1
JTDI: JTAG10.8, JTAG20.5
JTDO: JTAG10.6, JTAG20.13
JTMS: JTAG10.2, JTAG20.7
unnamed: JTAG10.7, JTAG10-7.1
unnamed: JTAG10.9, JTAG10-9.1
NJTRST: JTAG10.10, JTAG20.15
RSTN: JTAG20.3, RSTN.1

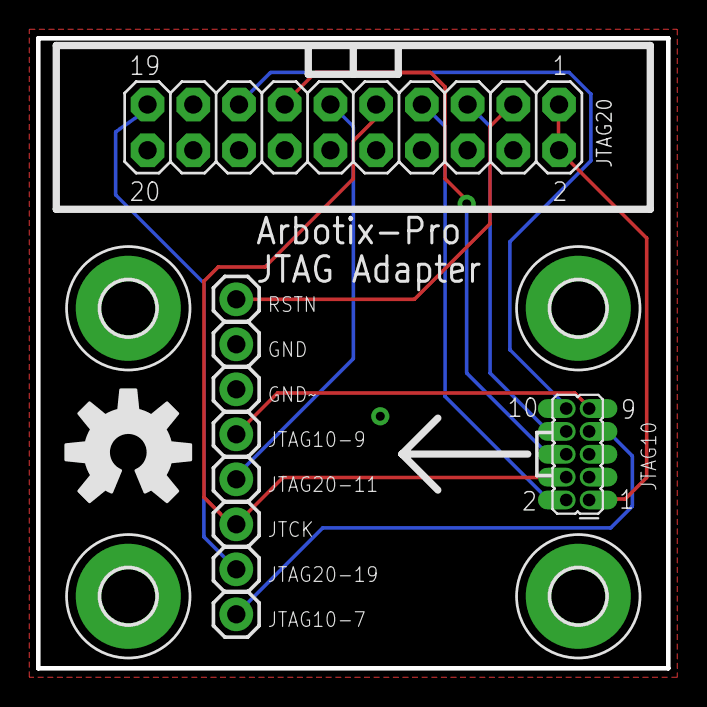
[picture p13: board ArbotixPro-JTAGProg.brd from above]

Board: 2 copper layers, 35.0 x 35.0 mm, 15 parts (0 on the bottom side), 12 nets.

Other parts of the board:
U$1: OSHW-LOGO-L
