Interbotix/ArbotixPro/hardware/ArbotixProv11.brd

## EAGLE design hardware/ArbotixProv11.brd (2015-04-29)

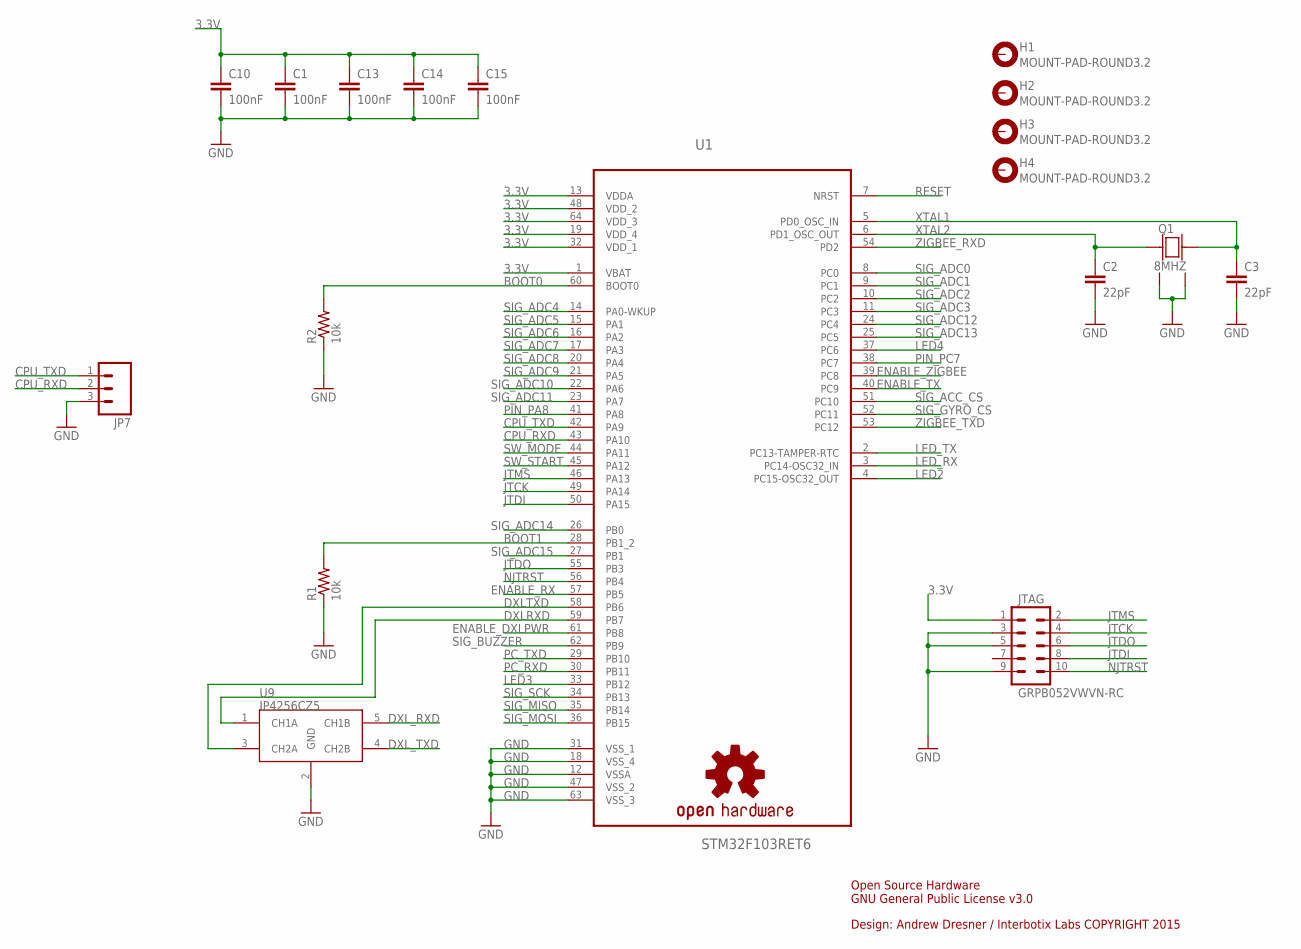
[picture p14: schematic ArbotixProv11.sch, sheet 1, MAIN]

Parts:
C1, C10, C13, C14, C15: 100nF; 0603-CAP
C2, C3: 22pF; 0603-CAP
H1, H2, H3, H4: MOUNT-PAD-ROUND3.2; 3,2-PAD
JP7: M03PTH; 1X03
JTAG: GRPB052VWVN-RC; 2X5_PTH_SILK_.05
LOGO1: OSHW-LOGOM; OSHW-LOGO-M
Q1: 8MHZ; 4LCC
R1, R2: 10k; 0603-RES
U1: STM32F103RET6; QFP50P1200X1200X160-64N
U9: IP4256CZ5; SOT665

Connections:
3.3V: C1.1, C10.1, C13.1, C14.1, C15.1, JTAG.1, U1.1 (VBAT), U1.13 (VDDA), U1.19 (VDD_4), U1.32 (VDD_1), U1.48 (VDD_2), U1.64 (VDD_3); also elsewhere on the board
BOOT0: R2.2, U1.60 (BOOT0)
BOOT1: R1.2, U1.28 (PB1_2)
CPU_RXD: JP7.2, U1.43 (PA10)
CPU_TXD: JP7.1, U1.42 (PA9)
DXLRXD: U1.59 (PB7), U9.1 (CH1A)
DXLTXD: U1.58 (PB6), U9.3 (CH2A)
DXL_RXD: U9.5 (CH1B); also elsewhere on the board
DXL_TXD: U9.4 (CH2B); also elsewhere on the board
ENABLE_DXLPWR: U1.61 (PB8); also elsewhere on the board
ENABLE_RX: U1.57 (PB5); also elsewhere on the board
ENABLE_TX: U1.40 (PC9); also elsewhere on the board
ENABLE_ZIGBEE: U1.39 (PC8); also elsewhere on the board
GND: C1.2, C2.2, C3.2, C10.2, C13.2, C14.2, C15.2, JP7.3, JTAG.3, JTAG.5, JTAG.9, Q1.2, Q1.4, R1.1, R2.1, U1.12 (VSSA), U1.18 (VSS_4), U1.31 (VSS_1), U1.47 (VSS_2), U1.63 (VSS_3), U9.2 (GND); also elsewhere on the board
JTCK: JTAG.4, U1.49 (PA14)
JTDI: JTAG.8, U1.50 (PA15)
JTDO: JTAG.6, U1.55 (PB3)
JTMS: JTAG.2, U1.46 (PA13)
LED2: U1.4 (PC15-OSC32_OUT); also elsewhere on the board
LED3: U1.33 (PB12); also elsewhere on the board
LED4: U1.37 (PC6); also elsewhere on the board
LED_RX: U1.3 (PC14-OSC32_IN); also elsewhere on the board
LED_TX: U1.2 (PC13-TAMPER-RTC); also elsewhere on the board
NJTRST: JTAG.10, U1.56 (PB4)
PC_RXD: U1.30 (PB11); also elsewhere on the board
PC_TXD: U1.29 (PB10); also elsewhere on the board
PIN_PA8: U1.41 (PA8); also elsewhere on the board
PIN_PC7: U1.38 (PC7)
RESET: U1.7 (NRST); also elsewhere on the board
SIG_ACC_CS: U1.51 (PC10); also elsewhere on the board
SIG_ADC0: U1.8 (PC0); also elsewhere on the board
SIG_ADC1: U1.9 (PC1); also elsewhere on the board
SIG_ADC2: U1.10 (PC2); also elsewhere on the board
SIG_ADC3: U1.11 (PC3); also elsewhere on the board
SIG_ADC4: U1.14 (PA0-WKUP); also elsewhere on the board
SIG_ADC5: U1.15 (PA1); also elsewhere on the board
SIG_ADC6: U1.16 (PA2); also elsewhere on the board
SIG_ADC7: U1.17 (PA3); also elsewhere on the board
SIG_ADC8: U1.20 (PA4); also elsewhere on the board
SIG_ADC9: U1.21 (PA5); also elsewhere on the board
SIG_ADC10: U1.22 (PA6); also elsewhere on the board
SIG_ADC11: U1.23 (PA7); also elsewhere on the board
SIG_ADC12: U1.24 (PC4); also elsewhere on the board
SIG_ADC13: U1.25 (PC5); also elsewhere on the board
SIG_ADC14: U1.26 (PB0); also elsewhere on the board
SIG_ADC15: U1.27 (PB1); also elsewhere on the board
SIG_BUZZER: U1.62 (PB9); also elsewhere on the board
SIG_GYRO_CS: U1.52 (PC11); also elsewhere on the board
SIG_MISO: U1.35 (PB14); also elsewhere on the board
SIG_MOSI: U1.36 (PB15); also elsewhere on the board
SIG_SCK: U1.34 (PB13); also elsewhere on the board
SW_MODE: U1.44 (PA11); also elsewhere on the board
SW_START: U1.45 (PA12); also elsewhere on the board
XTAL1: C3.1, Q1.3, U1.5 (PD0_OSC_IN)
XTAL2: C2.1, Q1.1, U1.6 (PD1_OSC_OUT)
ZIGBEE_RXD: U1.54 (PD2); also elsewhere on the board
ZIGBEE_TXD: U1.53 (PC12); also elsewhere on the board

Notes on the sheet:
Design: Andrew Dresner / Interbotix Labs COPYRIGHT 2015
Open Source Hardware GNU General Public License v3.0

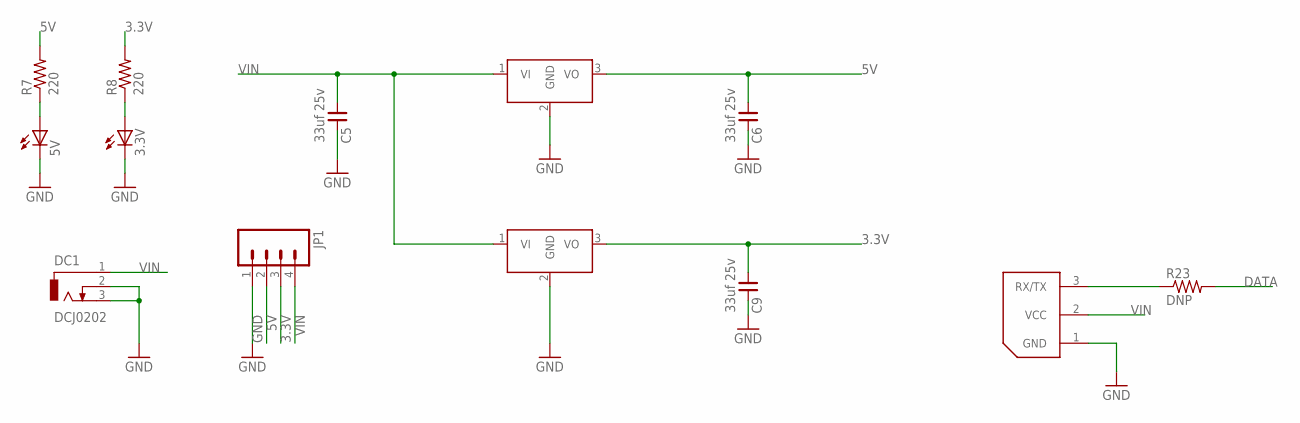
[picture p15: schematic ArbotixProv11.sch, sheet 2, Power]

Parts:
3.3V, 5V: LEDCHIPLED_0603; CHIPLED_0603
3V3REG: DCDC_OKI-78SR-3.3; OKI-78SRH
5VREG: DCDC_OKI-78SR-5; OKI-78SRH
C5, C6, C9: 33uf 25v; SV-C
CPU-POWER: WM18887-ND; BIOLOID
DC1: DCJ0202
JP1: M04PTH; 1X04
R7, R8: 220; 0603-RES
R23: DNP; 0603-RES

Connections:
3.3V: 3V3REG.3 (VO), C9.+ (1), JP1.3, R8.2; also elsewhere on the board
5V: 5VREG.3 (VO), C6.+ (1), JP1.2, R7.2; also elsewhere on the board
DATA: R23.2; also elsewhere on the board
GND: 3.3V.C, 3V3REG.2 (GND), 5V.C, 5VREG.2 (GND), C5.- (2), C6.- (2), C9.- (2), CPU-POWER.1 (GND), DC1.2, DC1.3, JP1.1; also elsewhere on the board
unnamed: CPU-POWER.3 (RX/TX), R23.1
unnamed: 5V.A, R7.1
unnamed: 3.3V.A, R8.1
VIN: 3V3REG.1 (VI), 5VREG.1 (VI), C5.+ (1), CPU-POWER.2 (VCC), DC1.1, JP1.4; also elsewhere on the board

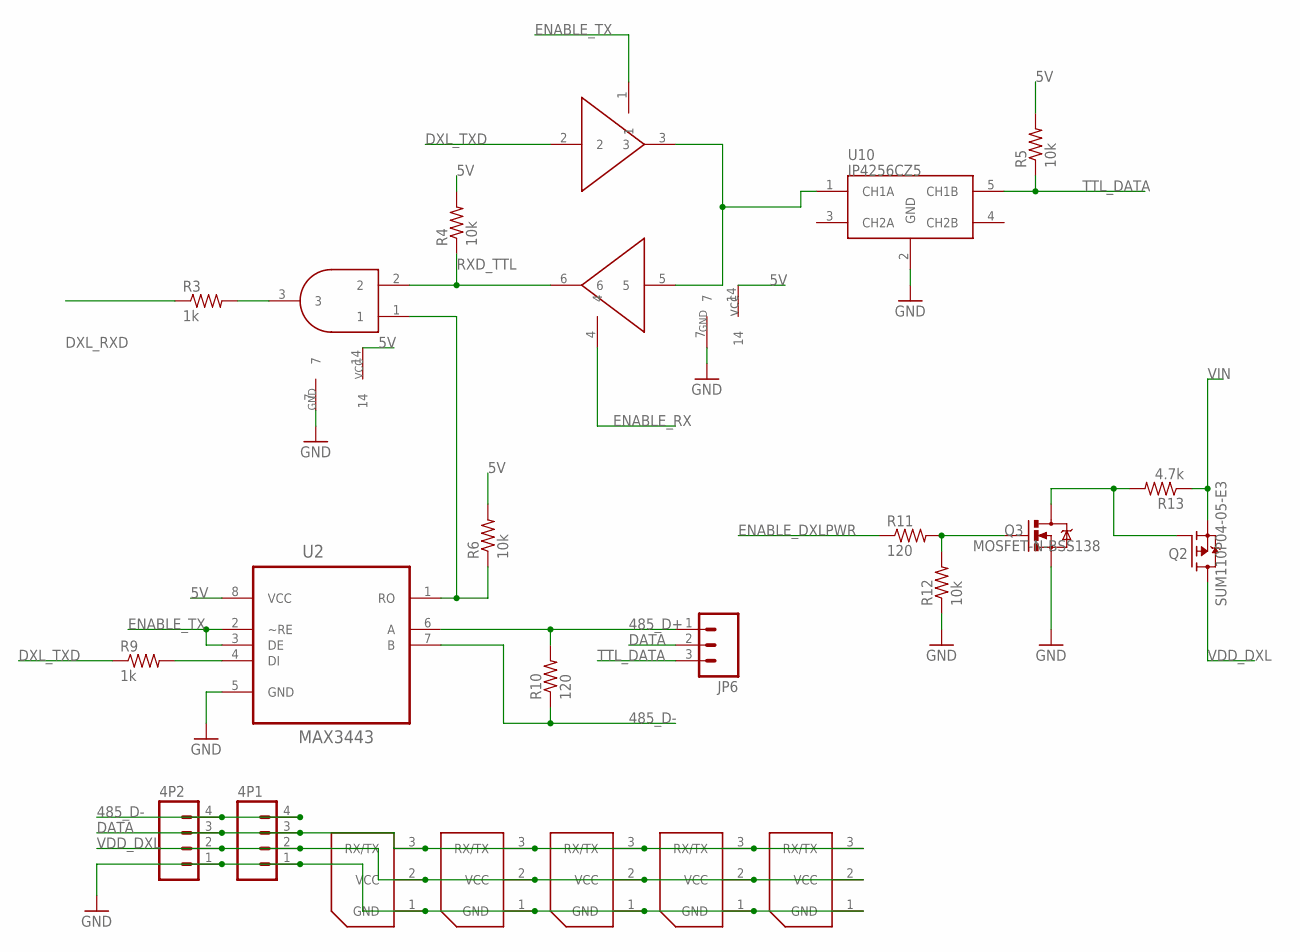
[picture p16: schematic ArbotixProv11.sch, sheet 3, DXL BUS]

Parts:
3P1, 3P2, 3P3, 3P4, 3P5: WM18887-ND; BIOLOID
4P1, 4P2: M04PTH; 1X04
JP6: M03PTH; 1X03
Q2: SUM110P04-05-E3; TO263
Q3: MOSFET-N-BSS138; SOT23
R3, R9: 1k; 0603-RES
R4, R5, R6, R12: 10k; 0603-RES
R10, R11: 120; 0603-RES
R13: 4.7k; 0603-RES
U2: MAX3443; SOIC127P600X175-8N
U6: 74HC08D,653; 14-SOIC
U7: 74HC126D,653; 14-SOIC
U10: IP4256CZ5; SOT665

Connections:
5V: R4.2, R5.2, R6.2, U2.8 (VCC), U6.14, U7.14; also elsewhere on the board
485_D+: JP6.1, R10.2, U2.6 (A)
485_D-: 4P1.4, 4P2.4, R10.1, U2.7 (B)
DATA: 3P1.3 (RX/TX), 3P2.3 (RX/TX), 3P3.3 (RX/TX), 3P4.3 (RX/TX), 3P5.3 (RX/TX), 4P1.3, 4P2.3, JP6.2; also elsewhere on the board
DXL_RXD: R3.1; also elsewhere on the board
DXL_TXD: R9.1, U7.2; also elsewhere on the board
ENABLE_DXLPWR: R11.1; also elsewhere on the board
ENABLE_RX: U7.4; also elsewhere on the board
ENABLE_TX: U2.2 (~RE), U2.3 (DE), U7.1; also elsewhere on the board
GND: 3P1.1 (GND), 3P2.1 (GND), 3P3.1 (GND), 3P4.1 (GND), 3P5.1 (GND), 4P1.1, 4P2.1, Q3.2 (S), R12.1, U2.5 (GND), U6.7, U7.7, U10.2 (GND); also elsewhere on the board
unnamed: Q3.1 (G), R11.2, R12.2
unnamed: R3.2, U6.3
unnamed: R9.2, U2.4 (DI)
unnamed: R6.1, U2.1 (RO), U6.1
unnamed: Q2.1 (G), Q3.3 (D), R13.2
unnamed: U7.3, U7.5, U10.1 (CH1A)
RXD_TTL: R4.1, U6.2, U7.6
TTL_DATA: JP6.3, R5.1, U10.5 (CH1B)
VDD_DXL: 3P1.2 (VCC), 3P2.2 (VCC), 3P3.2 (VCC), 3P4.2 (VCC), 3P5.2 (VCC), 4P1.2, 4P2.2, Q2.3 (D)
VIN: Q2.2 (S), R13.1; also elsewhere on the board

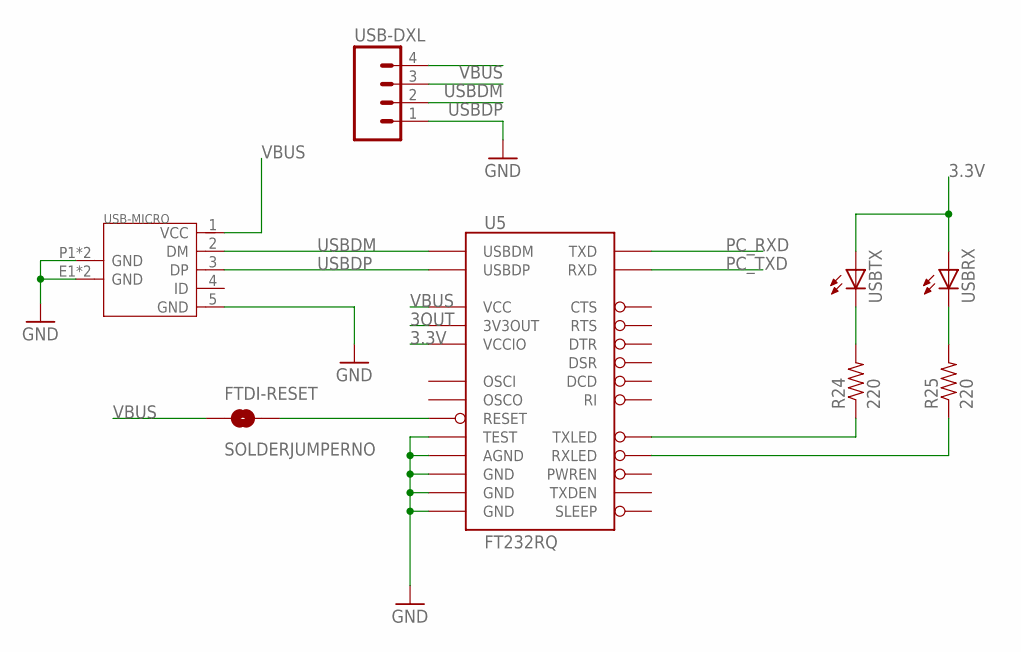
[picture p17: schematic ArbotixProv11.sch, sheet 4, USB-FTDI-TERMINAL]

Parts:
FTDI-RESET: SOLDERJUMPERNO; SJ_2S-NO
R24, R25: 220; 0603-RES
U5: FT232RQ; QFN-32
USB-DXL: M04PTH; 1X04
USB-MICRO: MICRO-USB-5P-340015001; B-SMD-5P
USBRX: LEDCHIPLED_0603; CHIPLED_0603
USBTX: LEDCHIPLED_0603; CHIPLED_0603

Connections:
3.3V: U5.1 (VCCIO), USBRX.A, USBTX.A; also elsewhere on the board
3OUT: U5.16 (3V3OUT)
GND: U5.4 (GND), U5.17 (GND), U5.20 (GND), U5.24 (AGND), U5.26 (TEST), USB-DXL.1, USB-MICRO.5 (GND), USB-MICRO.E1 (GND), USB-MICRO.E2 (GND), USB-MICRO.P1 (GND), USB-MICRO.P2 (GND); also elsewhere on the board
unnamed: FTDI-RESET.2, U5.18 (RESET)
unnamed: R24.2, USBTX.C
unnamed: R25.2, USBRX.C
unnamed: R24.1, U5.22 (TXLED)
unnamed: R25.1, U5.21 (RXLED)
PC_RXD: U5.30 (TXD); also elsewhere on the board
PC_TXD: U5.2 (RXD); also elsewhere on the board
USBDM: U5.15 (USBDM), USB-DXL.3, USB-MICRO.2 (DM)
USBDP: U5.14 (USBDP), USB-DXL.2, USB-MICRO.3 (DP)
VBUS: FTDI-RESET.1, U5.19 (VCC), USB-DXL.4, USB-MICRO.1 (VCC)

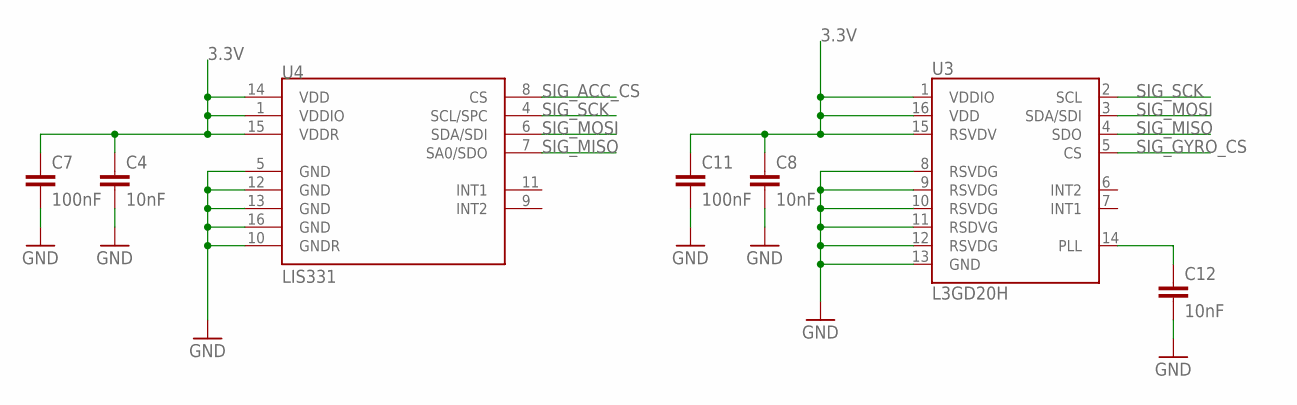
[picture p18: schematic ArbotixProv11.sch, sheet 5, ACC/GYRO]

Parts:
C4, C8, C12: 10nF; 0603-CAP
C7, C11: 100nF; 0603-CAP
U3: L3GD20H; LGA16-3MM
U4: LIS331; LGA16-3MM

Connections:
3.3V: C4.1, C7.1, C8.1, C11.1, U3.1 (VDDIO), U3.15 (RSVDV), U3.16 (VDD), U4.1 (VDDIO), U4.14 (VDD), U4.15 (VDDR); also elsewhere on the board
GND: C4.2, C7.2, C8.2, C11.2, C12.2, U3.8 (RSVDG), U3.9 (RSVDG), U3.10 (RSVDG), U3.11 (RSDVG), U3.12 (RSVDG), U3.13 (GND), U4.5 (GND), U4.10 (GNDR), U4.12 (GND), U4.13 (GND), U4.16 (GND); also elsewhere on the board
unnamed: C12.1, U3.14 (PLL)
SIG_ACC_CS: U4.8 (CS); also elsewhere on the board
SIG_GYRO_CS: U3.5 (CS); also elsewhere on the board
SIG_MISO: U3.4 (SDO), U4.7 (SA0/SDO); also elsewhere on the board
SIG_MOSI: U3.3 (SDA/SDI), U4.6 (SDA/SDI); also elsewhere on the board
SIG_SCK: U3.2 (SCL), U4.4 (SCL/SPC); also elsewhere on the board

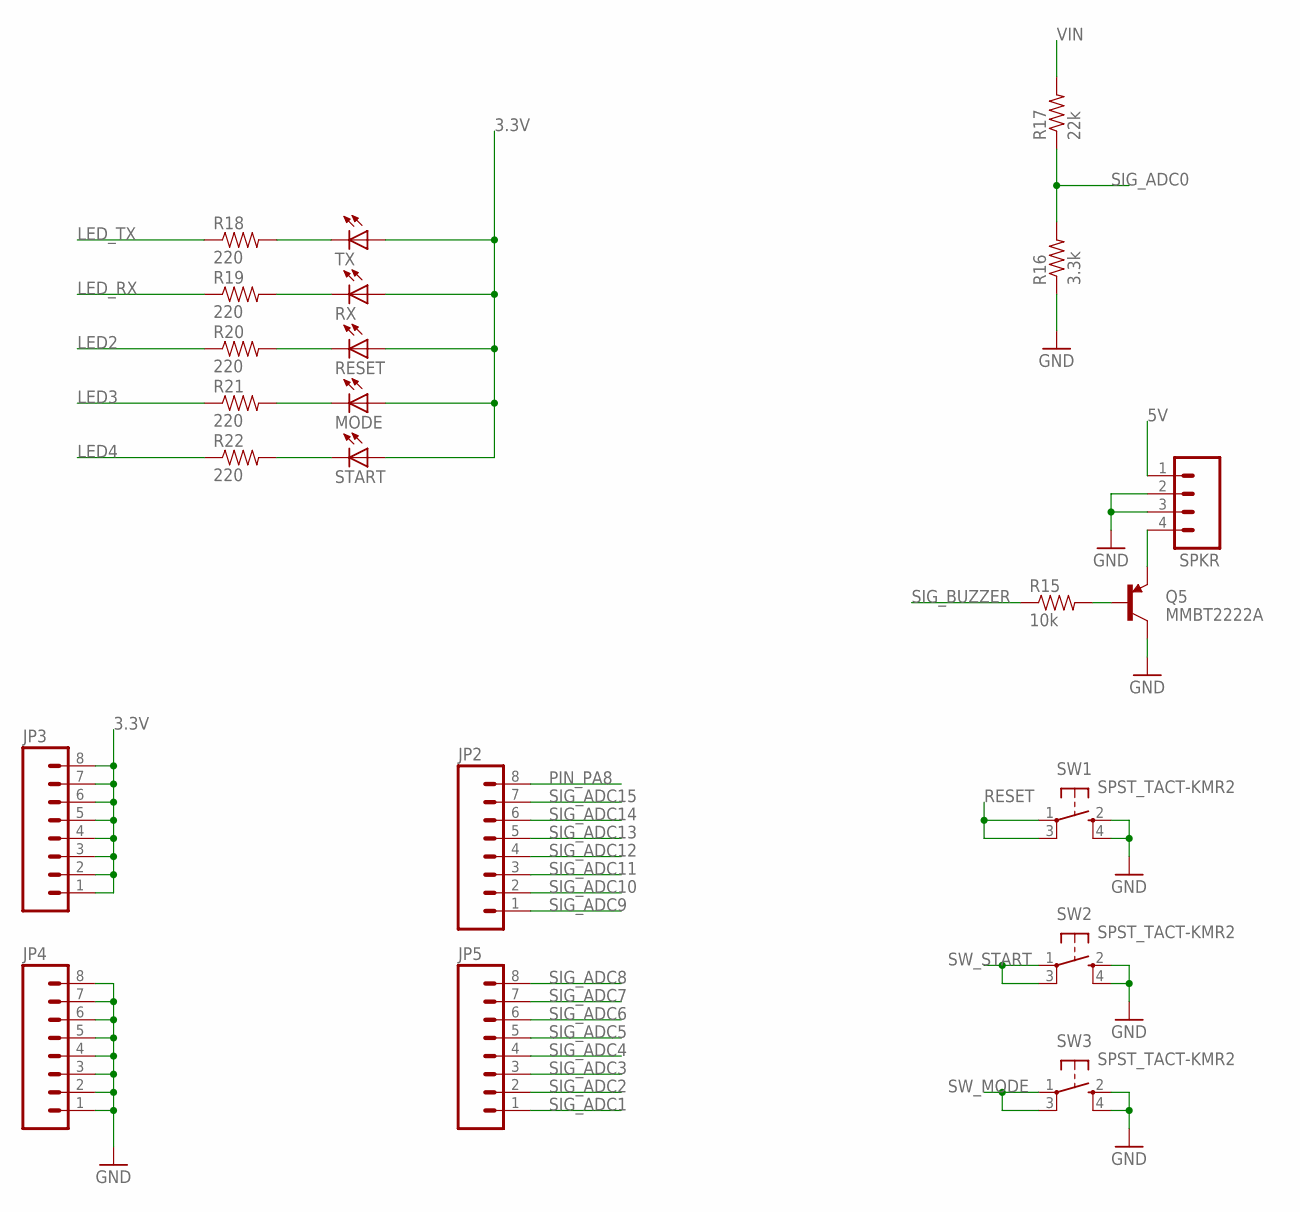
[picture p19: schematic ArbotixProv11.sch, sheet 6, IO]

Parts:
JP2, JP3, JP4, JP5: M08SILK_FEMALE_PTH; 1X08
MODE: LEDCHIP-LED0603; CHIP-LED0603
Q5: MMBT2222A; SOT23
R15: 10k; 0603-RES
R16: 3.3k; 0603-RES
R17: 22k; 0603-RES
R18, R19, R20, R21, R22: 220; 0603-RES
RESET: LEDCHIP-LED0603; CHIP-LED0603
RX: LEDCHIP-LED0603; CHIP-LED0603
SPKR: M04PTH; 1X04
START: LEDCHIP-LED0603; CHIP-LED0603
SW1, SW2, SW3: SPST_TACT-KMR2; KMR2
TX: LEDCHIP-LED0603; CHIP-LED0603

Connections:
3.3V: JP3.1, JP3.2, JP3.3, JP3.4, JP3.5, JP3.6, JP3.7, JP3.8, MODE.A, RESET.A, RX.A, START.A, TX.A; also elsewhere on the board
5V: SPKR.1; also elsewhere on the board
GND: JP4.1, JP4.2, JP4.3, JP4.4, JP4.5, JP4.6, JP4.7, JP4.8, Q5.3 (C), R16.1, SPKR.2, SPKR.3, SW1.2 (S), SW1.4 (S1), SW2.2 (S), SW2.4 (S1), SW3.2 (S), SW3.4 (S1); also elsewhere on the board
LED2: R20.1; also elsewhere on the board
LED3: R21.1; also elsewhere on the board
LED4: R22.1; also elsewhere on the board
LED_RX: R19.1; also elsewhere on the board
LED_TX: R18.1; also elsewhere on the board
unnamed: R18.2, TX.C
unnamed: R19.2, RX.C
unnamed: Q5.1 (B), R15.2
unnamed: Q5.2 (E), SPKR.4
unnamed: R20.2, RESET.C
unnamed: MODE.C, R21.2
unnamed: R22.2, START.C
PIN_PA8: JP2.8; also elsewhere on the board
RESET: SW1.1, SW1.3 (P1); also elsewhere on the board
SIG_ADC0: R16.2, R17.1; also elsewhere on the board
SIG_ADC1: JP5.1; also elsewhere on the board
SIG_ADC2: JP5.2; also elsewhere on the board
SIG_ADC3: JP5.3; also elsewhere on the board
SIG_ADC4: JP5.4; also elsewhere on the board
SIG_ADC5: JP5.5; also elsewhere on the board
SIG_ADC6: JP5.6; also elsewhere on the board
SIG_ADC7: JP5.7; also elsewhere on the board
SIG_ADC8: JP5.8; also elsewhere on the board
SIG_ADC9: JP2.1; also elsewhere on the board
SIG_ADC10: JP2.2; also elsewhere on the board
SIG_ADC11: JP2.3; also elsewhere on the board
SIG_ADC12: JP2.4; also elsewhere on the board
SIG_ADC13: JP2.5; also elsewhere on the board
SIG_ADC14: JP2.6; also elsewhere on the board
SIG_ADC15: JP2.7; also elsewhere on the board
SIG_BUZZER: R15.1; also elsewhere on the board
SW_MODE: SW3.1, SW3.3 (P1); also elsewhere on the board
SW_START: SW2.1, SW2.3 (P1); also elsewhere on the board
VIN: R17.2; also elsewhere on the board

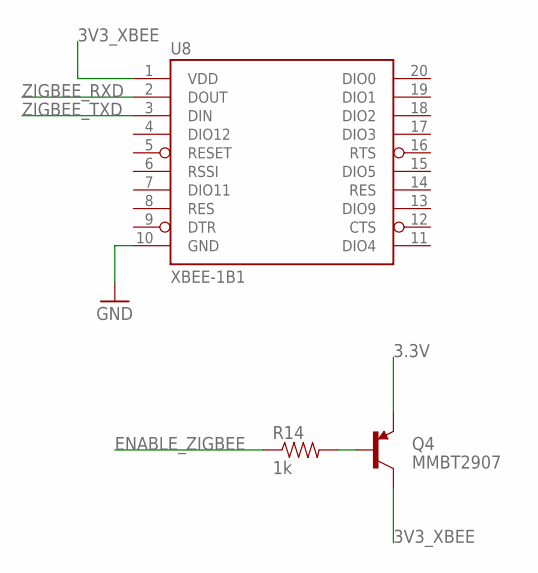
[picture p20: schematic ArbotixProv11.sch, sheet 7, Wireless]

Parts:
Q4: MMBT2907; SOT23
R14: 1k; 0603-RES
U8: XBEE-1B1; XBEE-1

Connections:
3.3V: Q4.2 (E); also elsewhere on the board
3V3_XBEE: Q4.3 (C), U8.1 (VDD)
ENABLE_ZIGBEE: R14.1; also elsewhere on the board
GND: U8.10 (GND); also elsewhere on the board
unnamed: Q4.1 (B), R14.2
ZIGBEE_RXD: U8.2 (DOUT); also elsewhere on the board
ZIGBEE_TXD: U8.3 (DIN); also elsewhere on the board

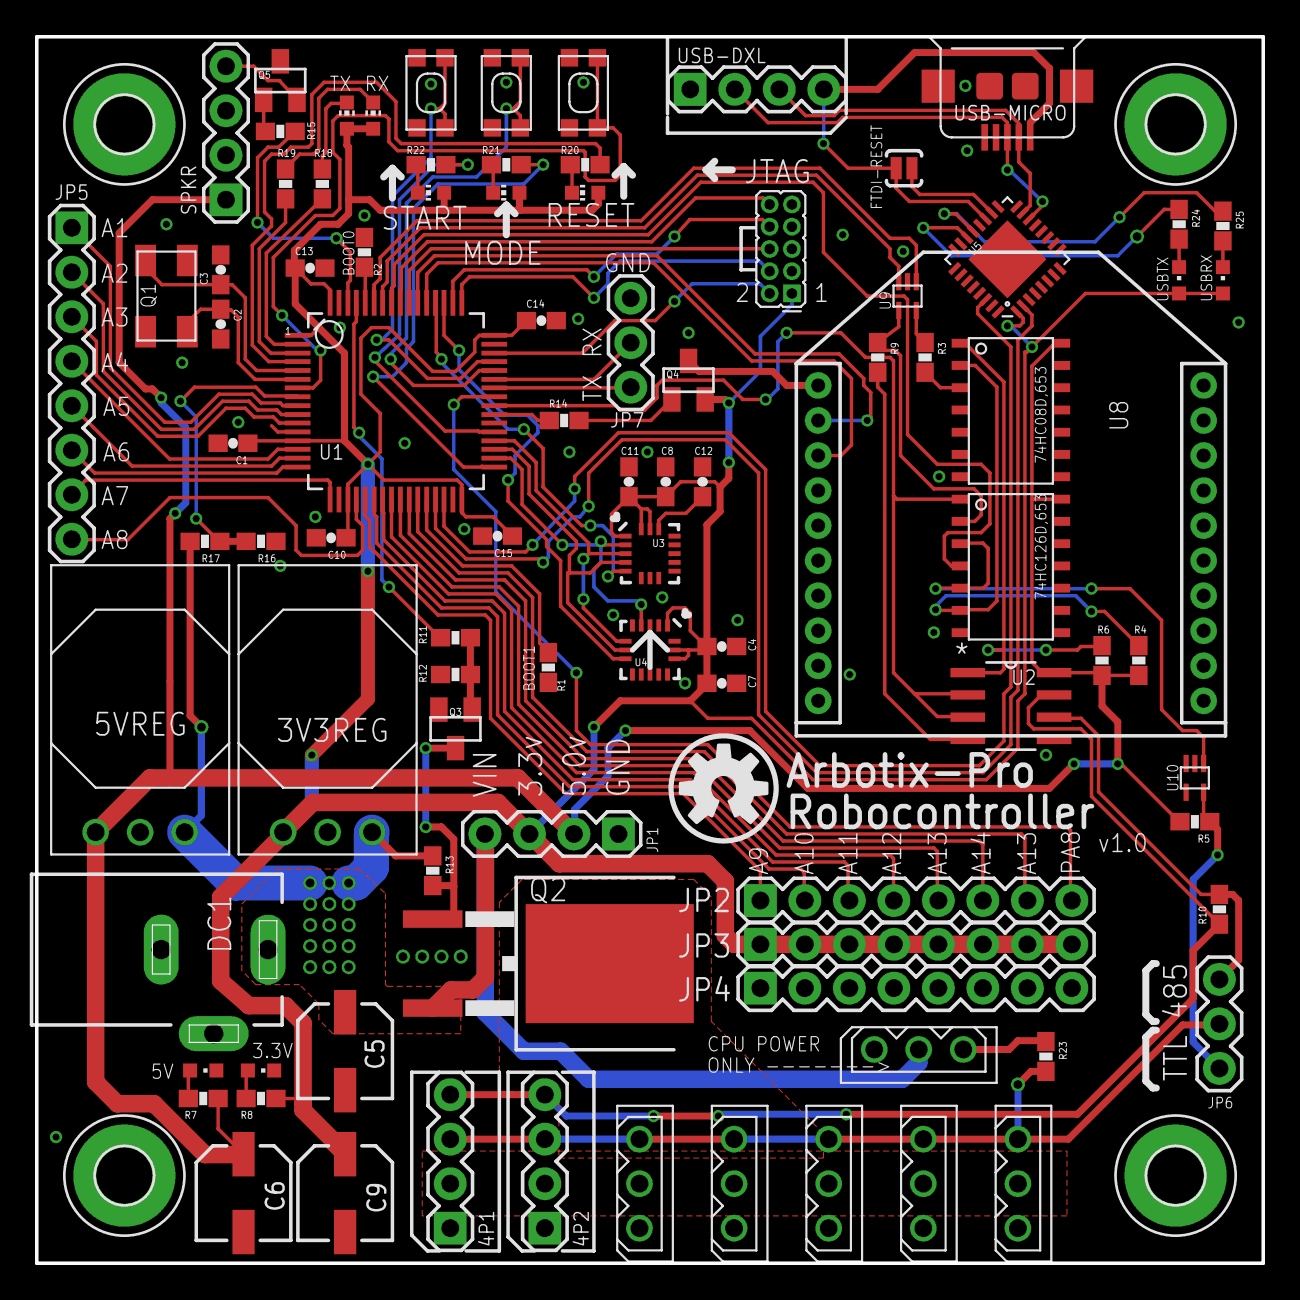
[picture p21: board ArbotixProv11.brd from above]

Board: 2 copper layers, 70.0 x 70.0 mm, 95 parts (0 on the bottom side), 91 nets.
