Interbotix/ArbotixPro/software/arbotixpro_cm730_firmware/CM730_APP/inc/dynamixel.h

/************************* (C) COPYRIGHT 2010 ROBOTIS *************************
* File Name          : dynamixel.h
* Author             : zerom
* Version            : V0.1
* Date               : 2010/08/26
* Description        : This file contains the dynamixel communication function.
                       for the firmware.
*******************************************************************************/

/* Define to prevent recursive inclusion -------------------------------------*/
#ifndef _DYNAMIXEL_HEADER
#define _DYNAMIXEL_HEADER

/* Includes ------------------------------------------------------------------*/
#include "common_type.h"
/* Exported types ------------------------------------------------------------*/

/* Exported constants --------------------------------------------------------*/


///////////// set/get packet methods //////////////////////////
#define MAXNUM_TXPARAM		(150)
#define MAXNUM_RXPARAM		(60)

#define BROADCAST_ID		(254)

#define INST_PING           0x01
#define INST_READ           0x02
#define INST_WRITE          0x03
#define INST_REG_WRITE      0x04
#define INST_ACTION         0x05
#define INST_RESET          0x06
#define INST_DIGITAL_RESET  0x07
#define INST_SYSTEM_READ    0x0C
#define INST_SYSTEM_WRITE   0x0D
#define INST_SYNC_WRITE     0x83
#define INST_SYNC_REG_WRITE 0x84
#define INST_BULK_READ 		0x92

#define ERRBIT_VOLTAGE		(1)
#define ERRBIT_ANGLE		(2)
#define ERRBIT_OVERHEAT		(4)
#define ERRBIT_RANGE		(8)
#define ERRBIT_CHECKSUM		(16)
#define ERRBIT_OVERLOAD		(32)
#define ERRBIT_INSTRUCTION	(64)

#define	COMM_TXSUCCESS		(0)
#define COMM_RXSUCCESS		(1)
#define COMM_TXFAIL			(2)
#define COMM_RXFAIL			(3)
#define COMM_TXERROR		(4)
#define COMM_RXWAITING		(5)
#define COMM_RXTIMEOUT		(6)
#define COMM_RXCORRUPT		(7)


/* Exported macro ------------------------------------------------------------*/
/*
///////////// device control methods ////////////////////////
int dxl_initialize( int devIndex, unsigned long int baudnum );
void dxl_terminate();


void dxl_set_txpacket_id(int id);

void dxl_set_txpacket_instruction(int instruction);

void dxl_set_txpacket_parameter(int index, int value);
void dxl_set_txpacket_length(int length);

int dxl_get_rxpacket_error(int errbit);


int dxl_get_rxpacket_length(void);
int dxl_get_rxpacket_parameter(int index);


// utility for value
int dxl_makeword(int lowbyte, int highbyte);
int dxl_get_lowbyte(int word);
int dxl_get_highbyte(int word);


////////// packet communication methods ///////////////////////
void dxl_tx_packet(void);
void dxl_rx_packet(void);
void dxl_txrx_packet(void);

int dxl_get_result(void);



//////////// high communication methods ///////////////////////
void dxl_ping(int id);
int dxl_read_byte(int id, int address);
void dxl_write_byte(int id, int address, int value);
int dxl_read_word(int id, int address);
void dxl_write_word(int id, int address, int value);

*/


/* Exported variables ---------------------------------------------------------*/

#endif /* _DYNAMIXEL_HEADER */

/************************ (C) COPYRIGHT 2010 ROBOTIS *********END OF FILE******/
