Interbotix/ArbotixPro/software/arbotixpro_cm730_firmware/CM730_APP/inc/zigbee.h

// Zigbee SDK platform independent header
#ifndef _ZIGBEE_HEADER
#define _ZIGBEE_HEADER


#ifdef __cplusplus
extern "C" {
#endif

///////////// device control methods ////////////////////////
int zgb_initialize( int devIndex );
void zgb_terminate(void);

////////// communication methods ///////////////////////
int zgb_tx_data(int data);
int zgb_rx_check(void);
int zgb_rx_data(void);
unsigned short ScanZigbee(void);

///////// define RC-100 button key value ////////////////
#define RC100_BTN_U		(1)
#define RC100_BTN_D		(2)
#define RC100_BTN_L		(4)
#define RC100_BTN_R		(8)
#define RC100_BTN_1		(16)
#define RC100_BTN_2		(32)
#define RC100_BTN_3		(64)
#define RC100_BTN_4		(128)
#define RC100_BTN_5		(256)
#define RC100_BTN_6		(512)

#ifdef __cplusplus
}
#endif

#endif
