Interbotix/ArbotixPro/software/arbotixpro_cm730_firmware/CM730_HW/inc/led.h

/************************* (C) COPYRIGHT 2010 ROBOTIS *************************
* File Name          : led.h
* Author             : zerom
* Version            : V0.1
* Date               : 2010/08/24
* Description        : This file contains the defines used for LED fuctions
*******************************************************************************/

/* Define to prevent recursive inclusion -------------------------------------*/
#ifndef __LED_H
#define __LED_H

/* Includes ------------------------------------------------------------------*/
/* Exported types ------------------------------------------------------------*/
/* Exported constants --------------------------------------------------------*/

#define LED_MANAGE			0x1
#define LED_EDIT			0x2
#define	LED_PLAY			0x4
#define LED_TX				0x8
#define LED_RX				0x10
//#define LED_AUX				0x20
#define LED_POWER			0x40
#define LED_ALL				0x7F

#define LED_R		0x1
#define LED_G		0x2
#define LED_B		0x4


/* Exported macro ------------------------------------------------------------*/
/* Exported functions ------------------------------------------------------- */

void LED_SetState(u8 LED_PORT, PowerState NewState);
PowerState LED_GetState(u8 LED_PORT);
void LED_RGB_SetState(u8 RGB);
u8 LED_RGB_GetState();

#endif /* __LED_H */

/************************ (C) COPYRIGHT 2010 ROBOTIS ********END OF FILE*******/
