Interbotix/ArbotixPro/(commit log)

2015-04-29 added eaglecad files, restructure folders
    [Arbotix-Pro Digikey BOM v11.xlsx, ArbotixPro-JTAGProg.brd, ArbotixPro-JTAGProg.dxf, ArbotixPro-JTAGProg.sch, ArbotixPro.dxf, ArbotixProv11.brd, ArbotixProv11.sch]
2015-04-29 Added pin mappings xls
    [CM730-ArbotixPro Pin Mappings.xlsx]
2015-05-06 Added PDF Schematic
    Thanks Kurt!
